jc2brown/radio24bb/README.md

# Baseband Modem

This repo contains RTL, baremetal firmware, and application software (all WIP) for the "Baseband" modem hardware, a general-purpose FPGA/DSP playground intended to implement the low-frequency portion (<20MHz) of a radio system.

- [Schematic](https://github.com/jc2brown/radio24bb/blob/master/hw/Baseband_Schematic.pdf)
- [Gerbers](https://github.com/jc2brown/radio24bb/blob/master/hw/Baseband_PCB.pdf)
- [Power Tree](https://github.com/jc2brown/radio24bb/blob/master/hw/Baseband_PowerTree.pdf)

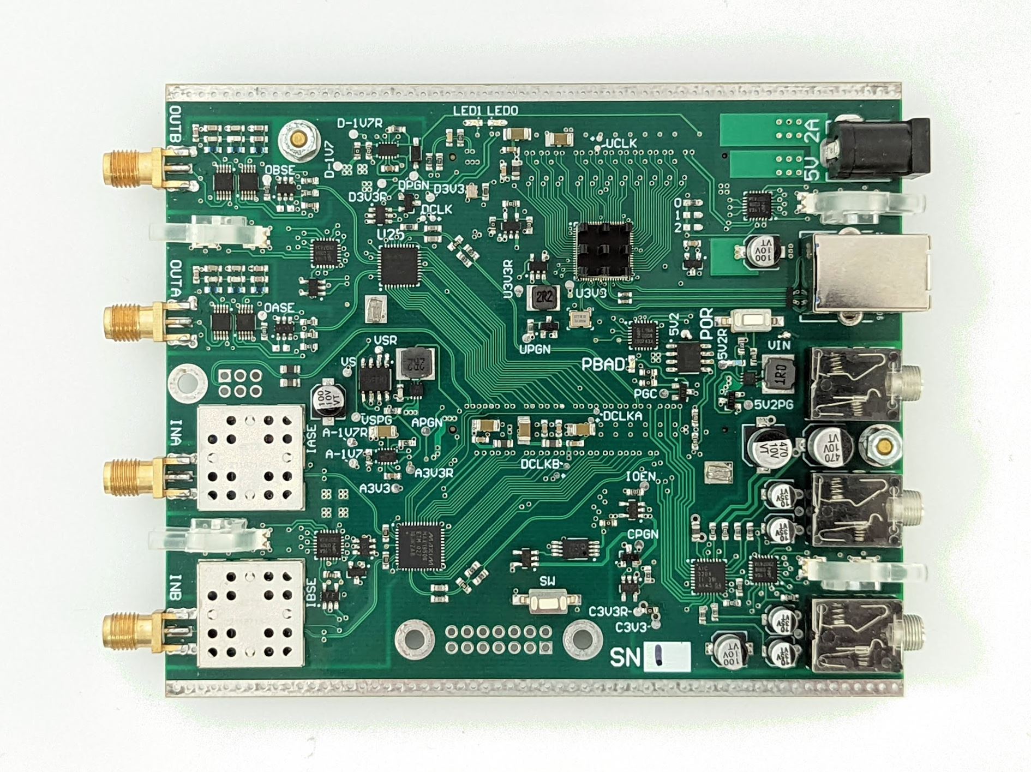
[picture p1: www/baseband_board_top.jpg]
Baseband board top view


### Generic Radio

Generic radio system

### This Implementation 

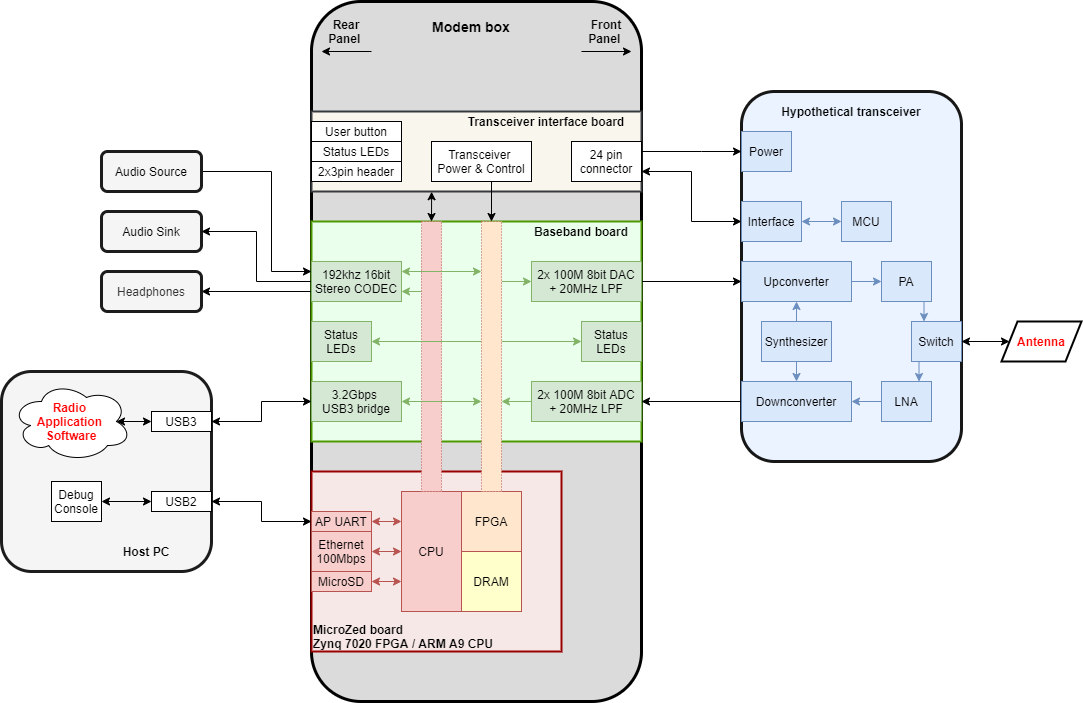
[picture p2: www/baseband_rxtx.png]
Block diagram


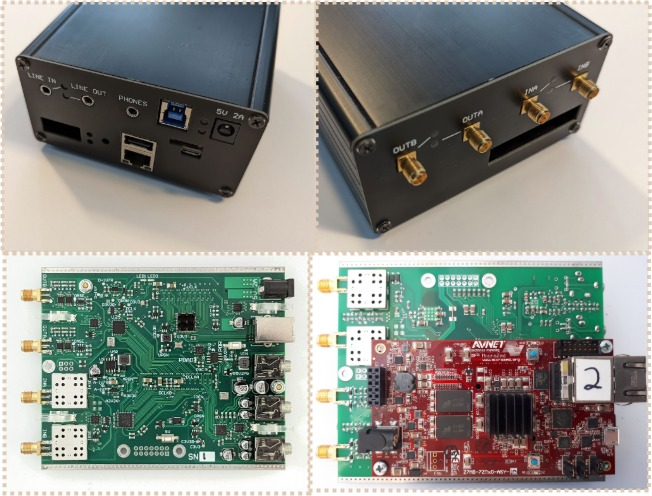
[picture p3: www/baseband_hw.jpg]
Baseband hardware
