jc2brown/radio24bb/rtl/readme.txt

Sources/Sinks

	ADC
		INA/INB (sources)
			Ext ATT
			Ext Filter
			Gain/Offset
			FIR filter

	DAC
		OUTA/OUTB (sinks)
			Ext ATT
			Ext Filter
			Gain/Offset
			FIR filter

	CODEC
		INL/INR (sources)
		OUTL/OUTR (sinks)

	USB
		IN (source)
		OUT (sink)

	DDSA/DDSB (sources)
		AM/FM/PM modulation

Blocks
	DDS
	FFT
	Filter
	Gain/Offset
	FM_Demod

TODO
	AM_Demod
	PM_Demod
	Resampler
