jc2brown/radio24bb/rtl/FT601_MCFIFO_Timing.png

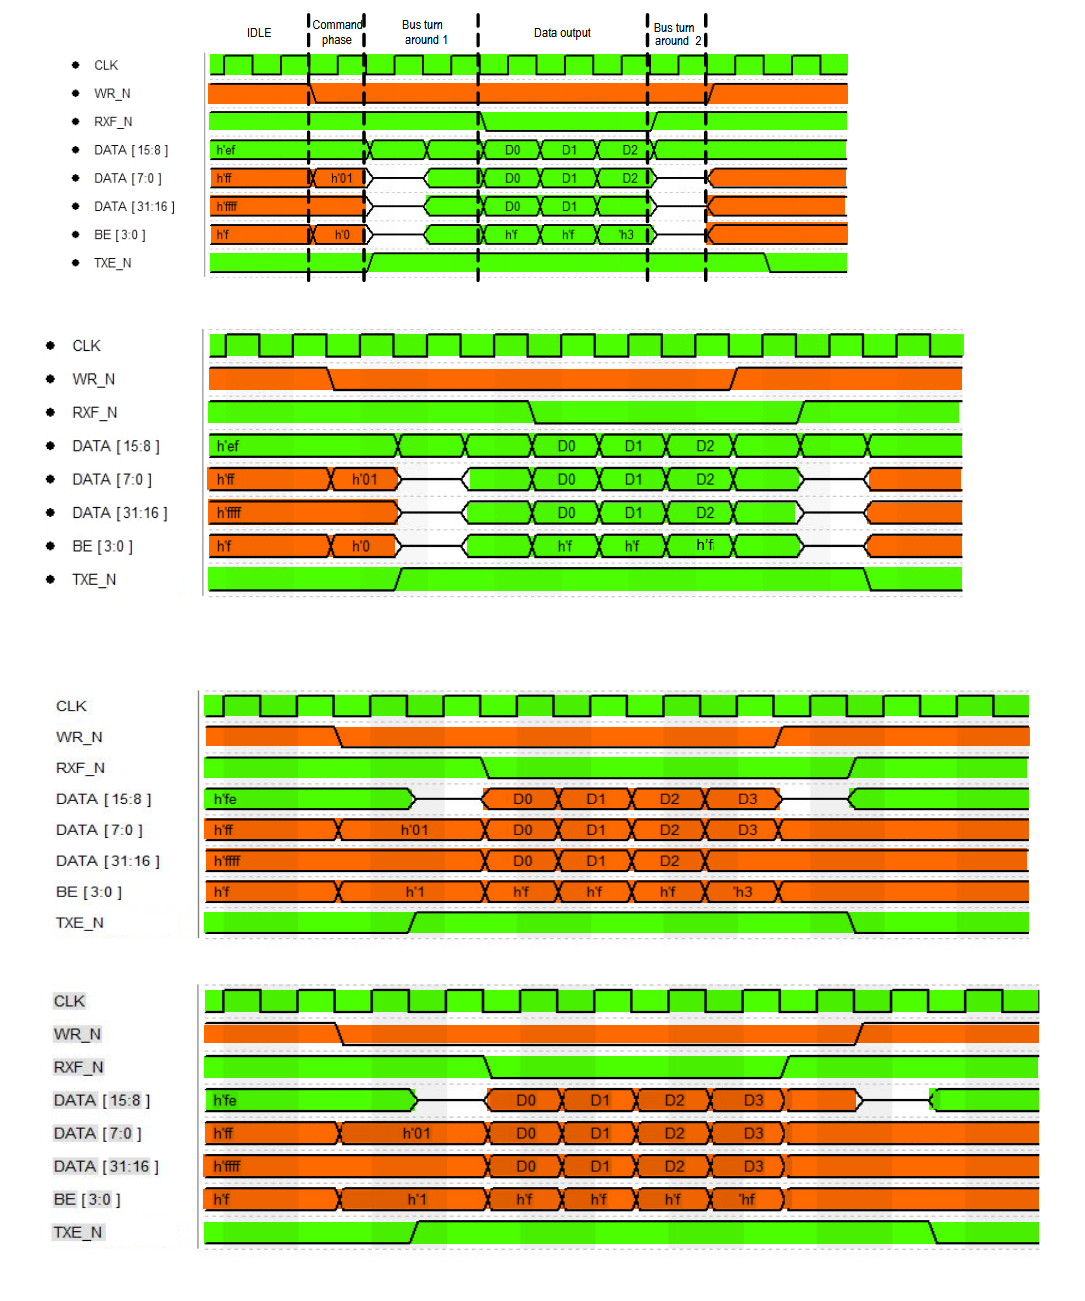
rtl/FT601_MCFIFO_Timing.png
