jc2brown/radio24bb/hw/Baseband_Schematic.pdf

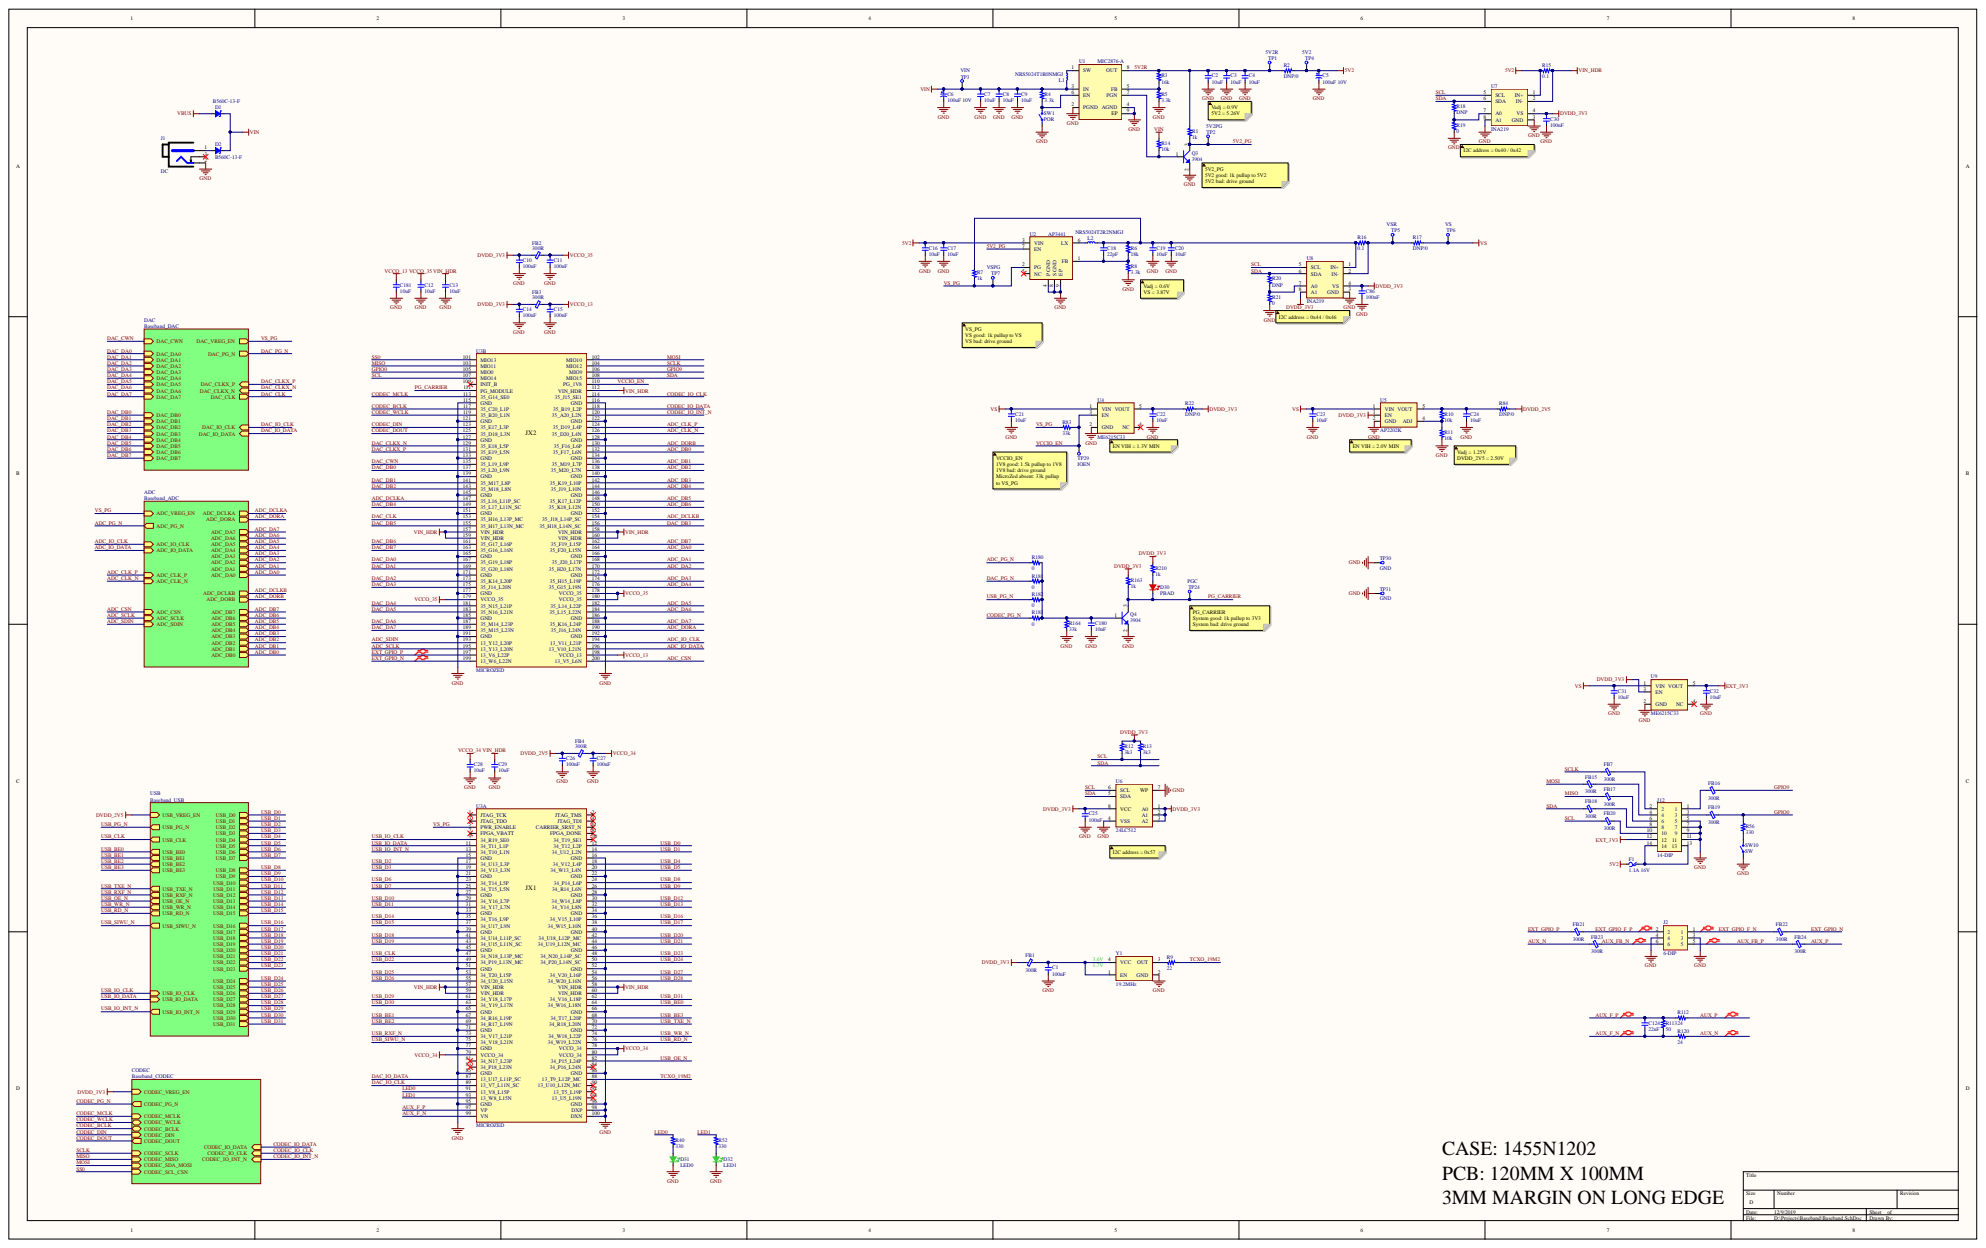
[picture p5: page 1]

DC GND DAC Baseband_DAC | DVDD_3V3 VCCO_13 C14 C15 100nF 100nF | | 5V2R 5V2 TP1 TP4 5V2 good: 1k pullup to 5V2 5V2 bad: drive ground

VS good: 1k pullup to VS
VS bad: drive ground

PG_CARRIER
System good: 1k pullup to 3V3
System bad: drive ground

CASE: 1455N1202
PCB: 120MM X 100MM
3MM MARGIN ON LONG EDGE

Size D | Number | Revision

Date: 12/9/2019 File: D:\Projects\Baseband\Baseband.SchDoc | Sheet of Drawn By:

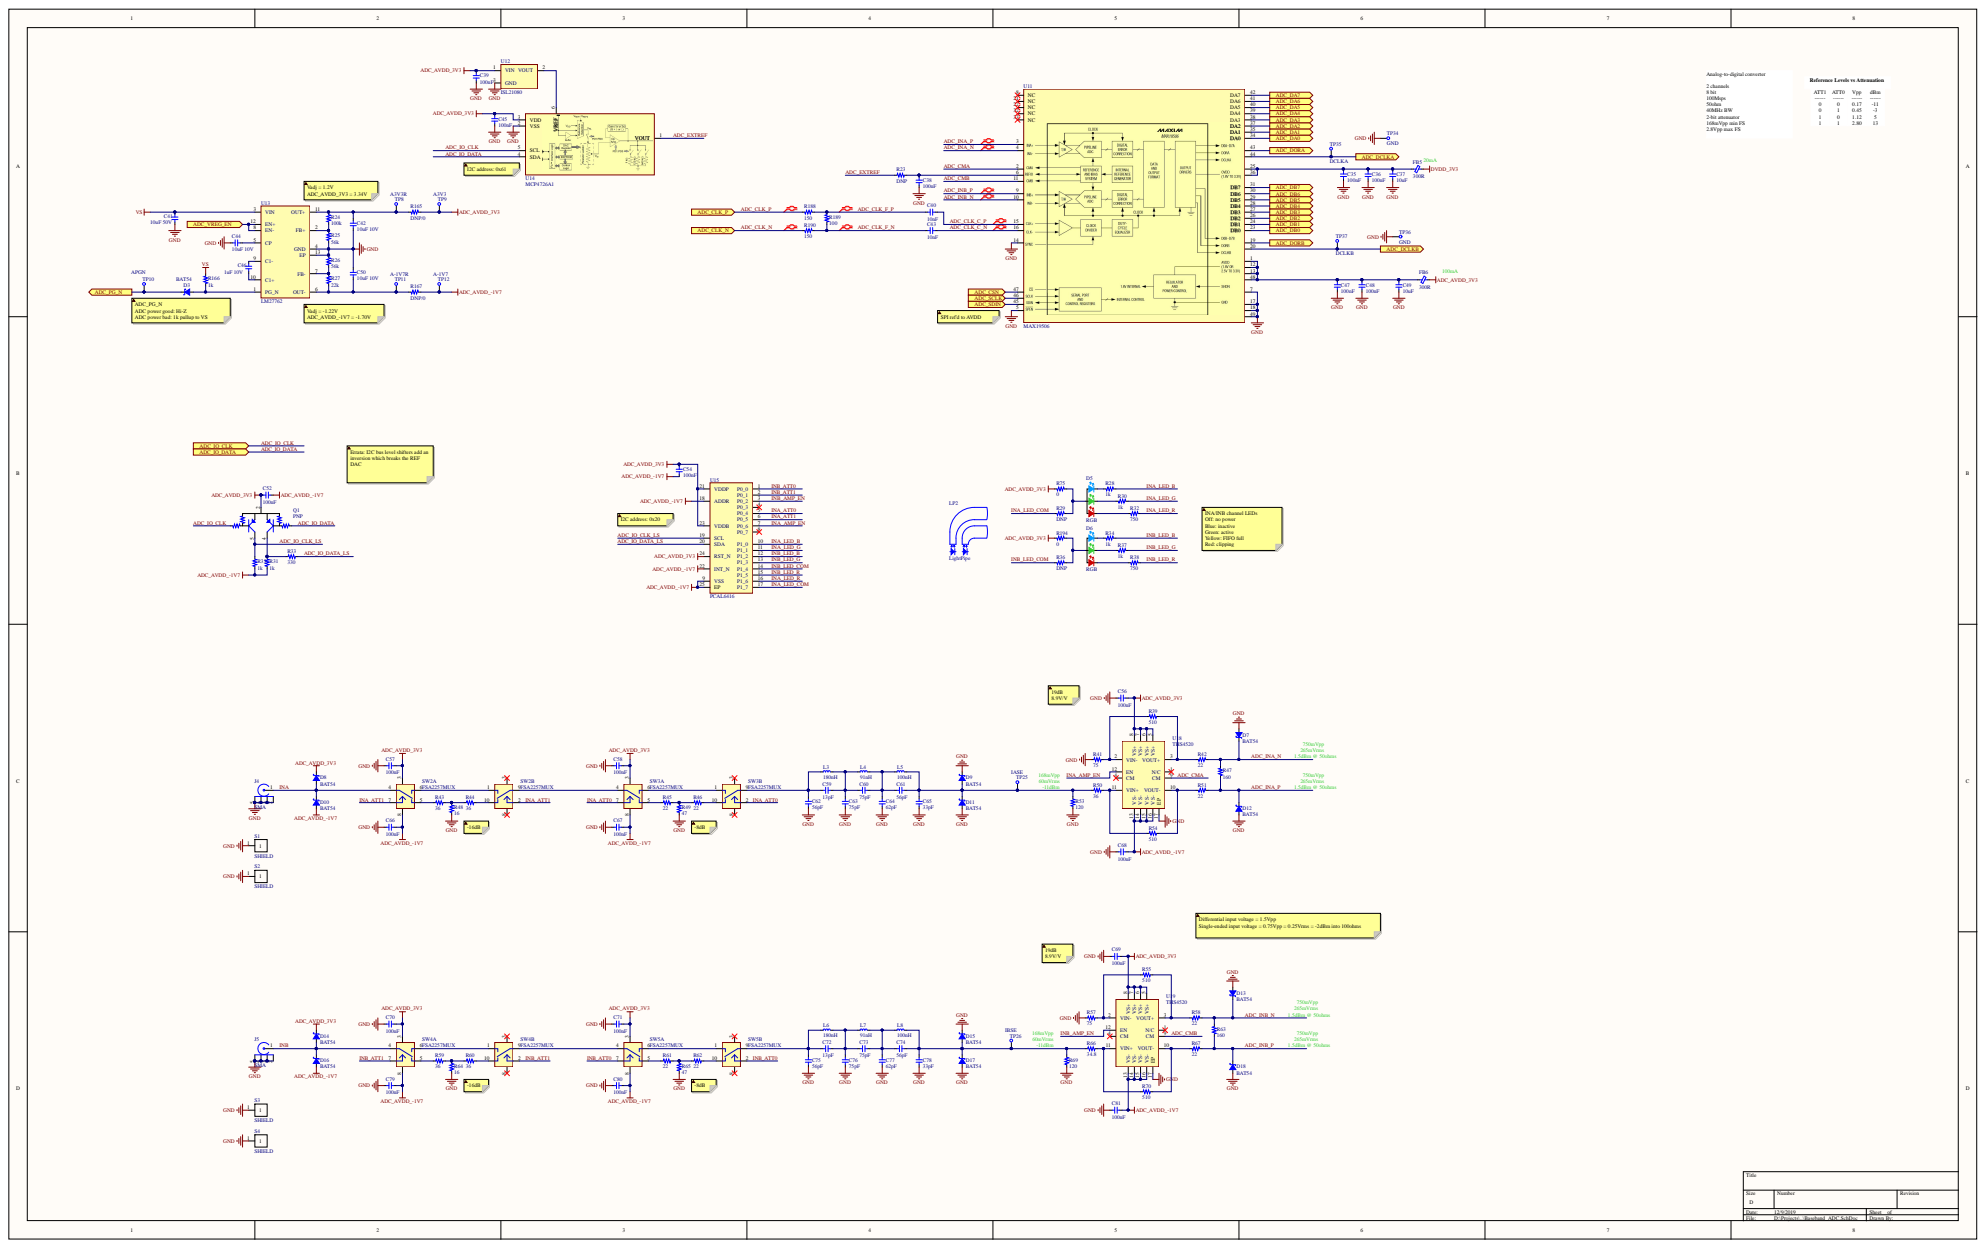
[picture p6: page 2]

Analog-to-digital converter

Reference Levels vs Attenuation

ADC_PG_N
ADC power good: Hi-Z
ADC power bad: 1k pullup to VS

SPI ref'd to AVDD

Errata: I2C bus level shifters add an
inversion which breaks the REF
DAC

INA/INB channel LEDs
Off: no power
Blue: inactive
Green: active
Yellow: FIFO full
Red: clipping

Differential input voltage = 1.5Vpp
Single-ended input voltage = 0.75Vpp = 0.25Vrms = -2dBm into 100ohms

Size D | Number | Revision

Date: 12/9/2019 File: D:\Projects\..\Baseband_ADC.SchDoc | Sheet of Drawn By:

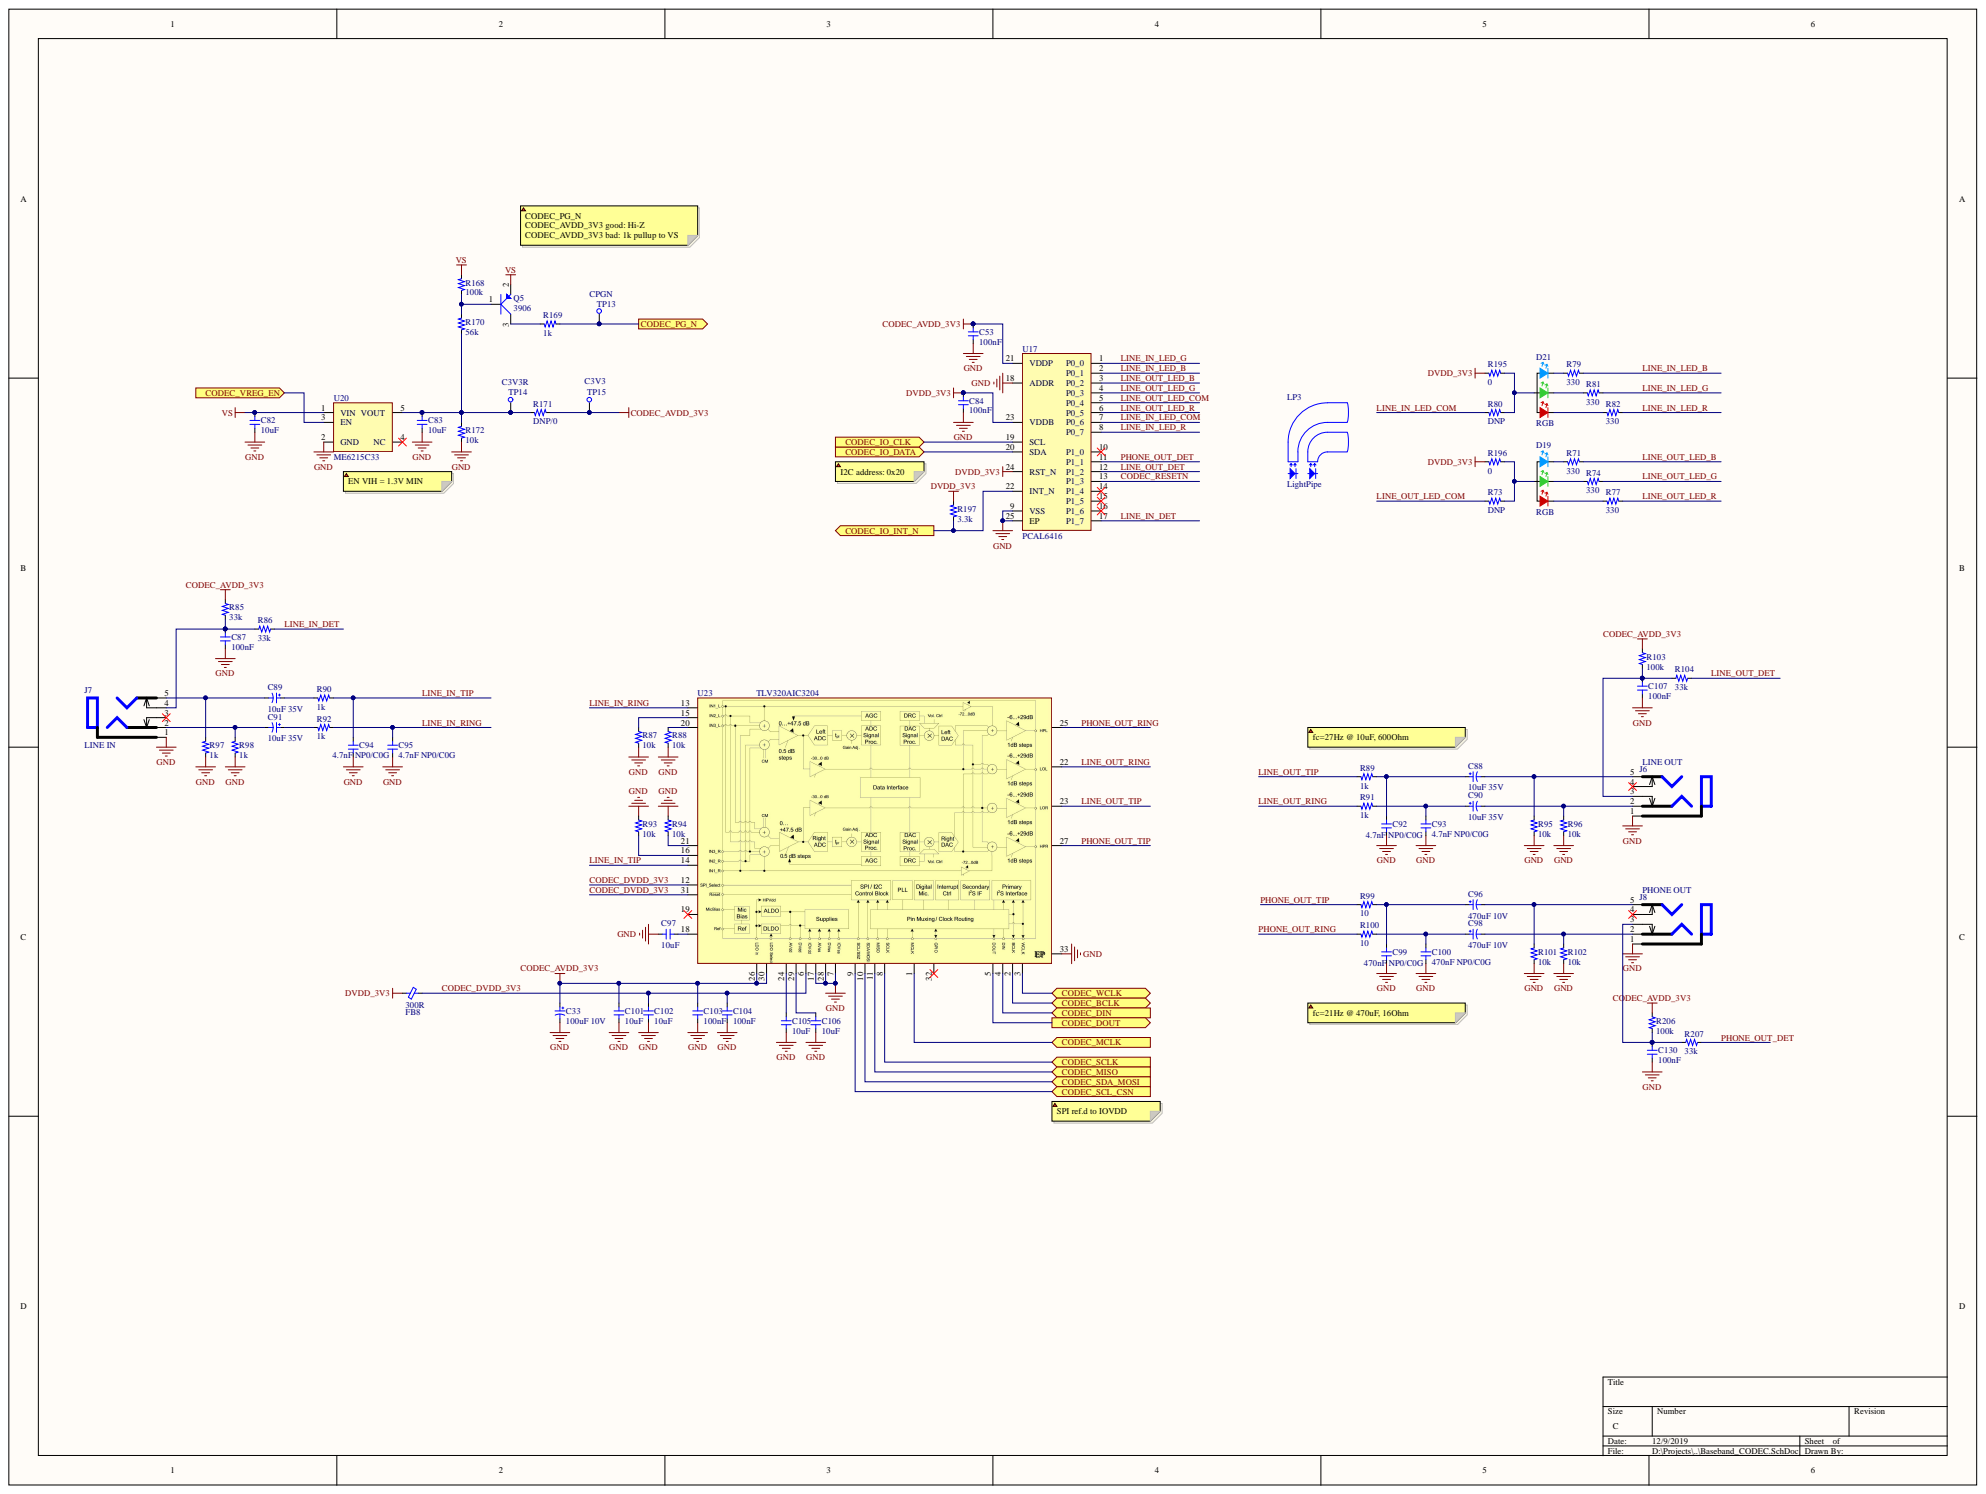
[picture p7: page 3]

CODEC_PG_N
CODEC_AVDD_3V3 good: Hi-Z
CODEC_AVDD_3V3 bad: 1k pullup to VS

SPI ref.d to IOVDD

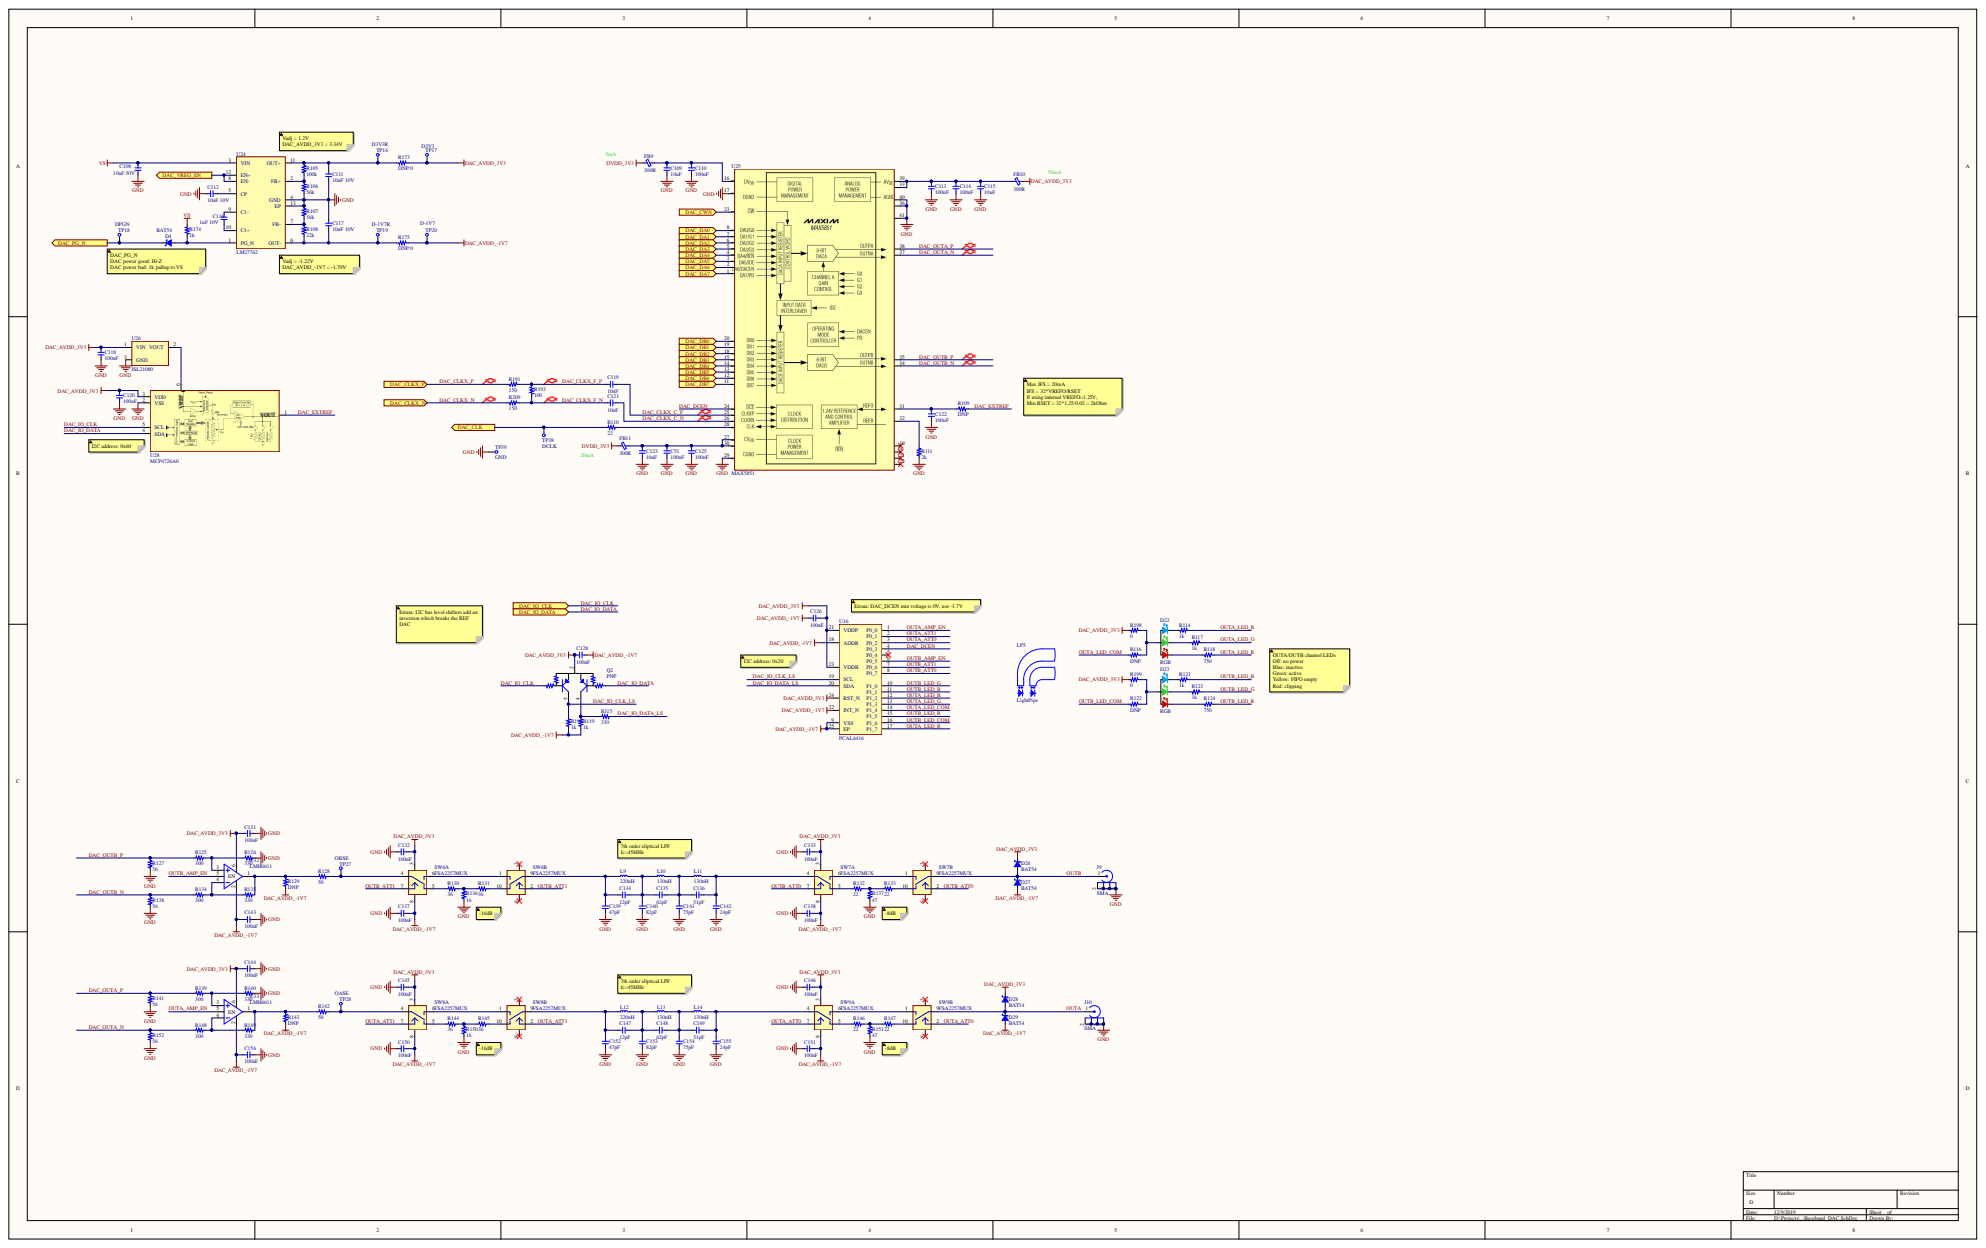
[picture p8: page 4]

DAC_PG_N
DAC power good: Hi-Z
DAC power bad: 1k pullup to VS

Max IFS = 20mA
IFS = 32*VREFO/RSET
If using internal VREFO=1.25V,
Min RSET = 32*1.25/0.02 = 2kOhm

Errata: DAC_DCEN min voltage is 0V, not -1.7V

Errata: I2C bus level shifters add an
inversion which breaks the REF
DAC

OUTA/OUTB channel LEDs
Off: no power
Blue: inactive
Green: active
Yellow: FIFO empty
Red: clipping

Size D | Number | Revision

Date: 12/9/2019 File: D:\Projects\..\Baseband_DAC.SchDoc | Sheet of Drawn By:

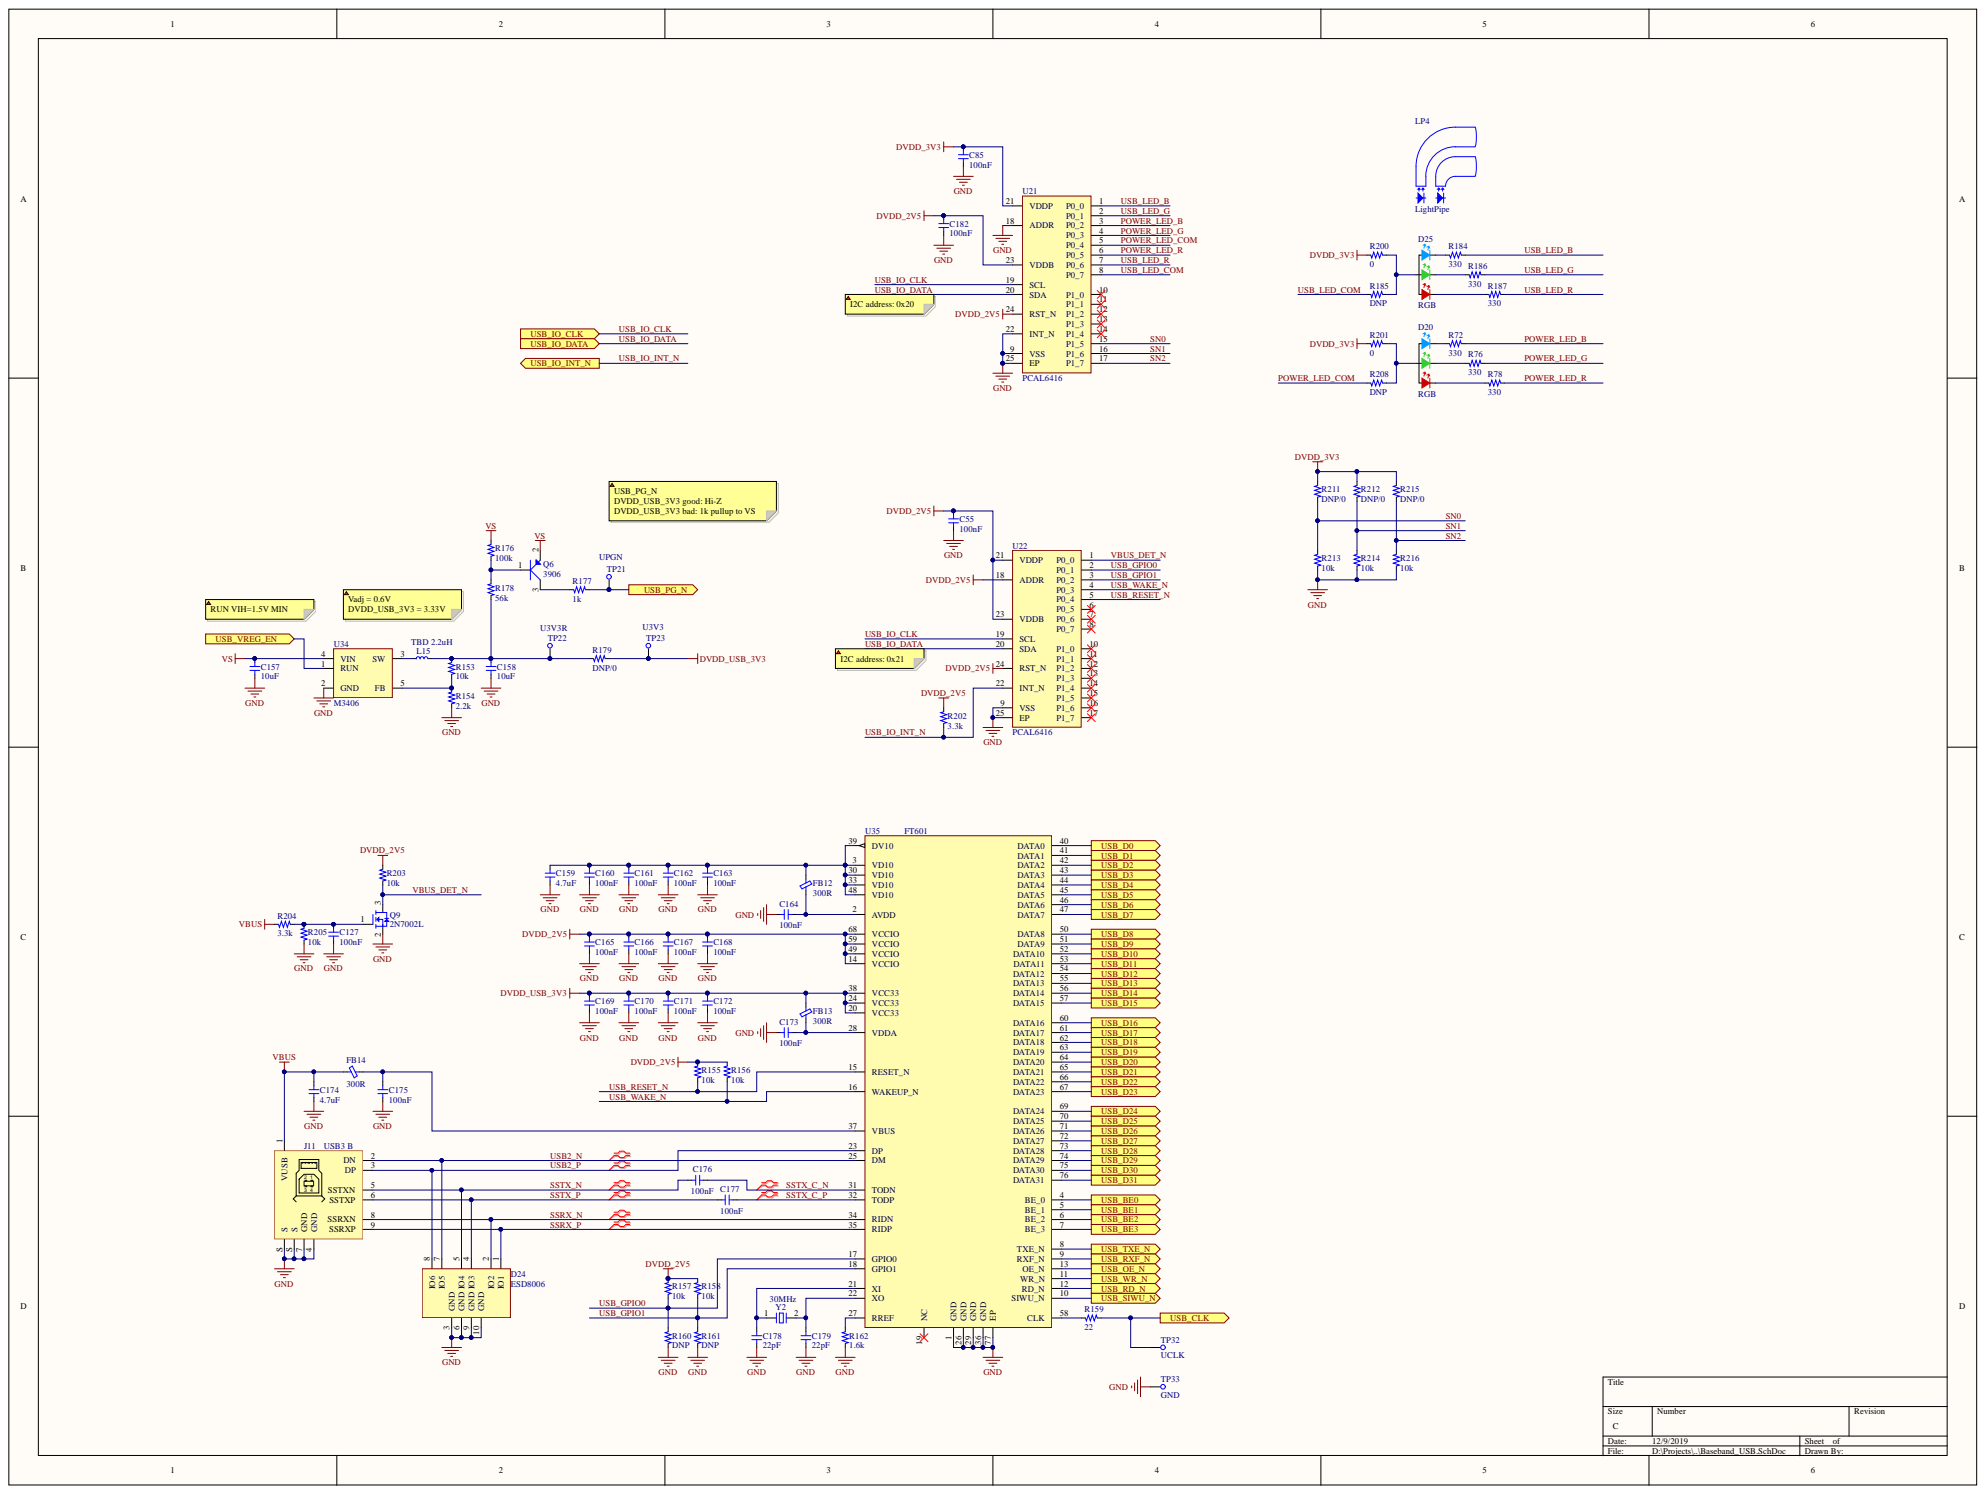
[picture p9: page 5]

USB_PG_N
DVDD_USB_3V3 good: Hi-Z
DVDD_USB_3V3 bad: 1k pullup to VS
