jc2brown/radio24bb/hw/Baseband_PowerTree.pdf

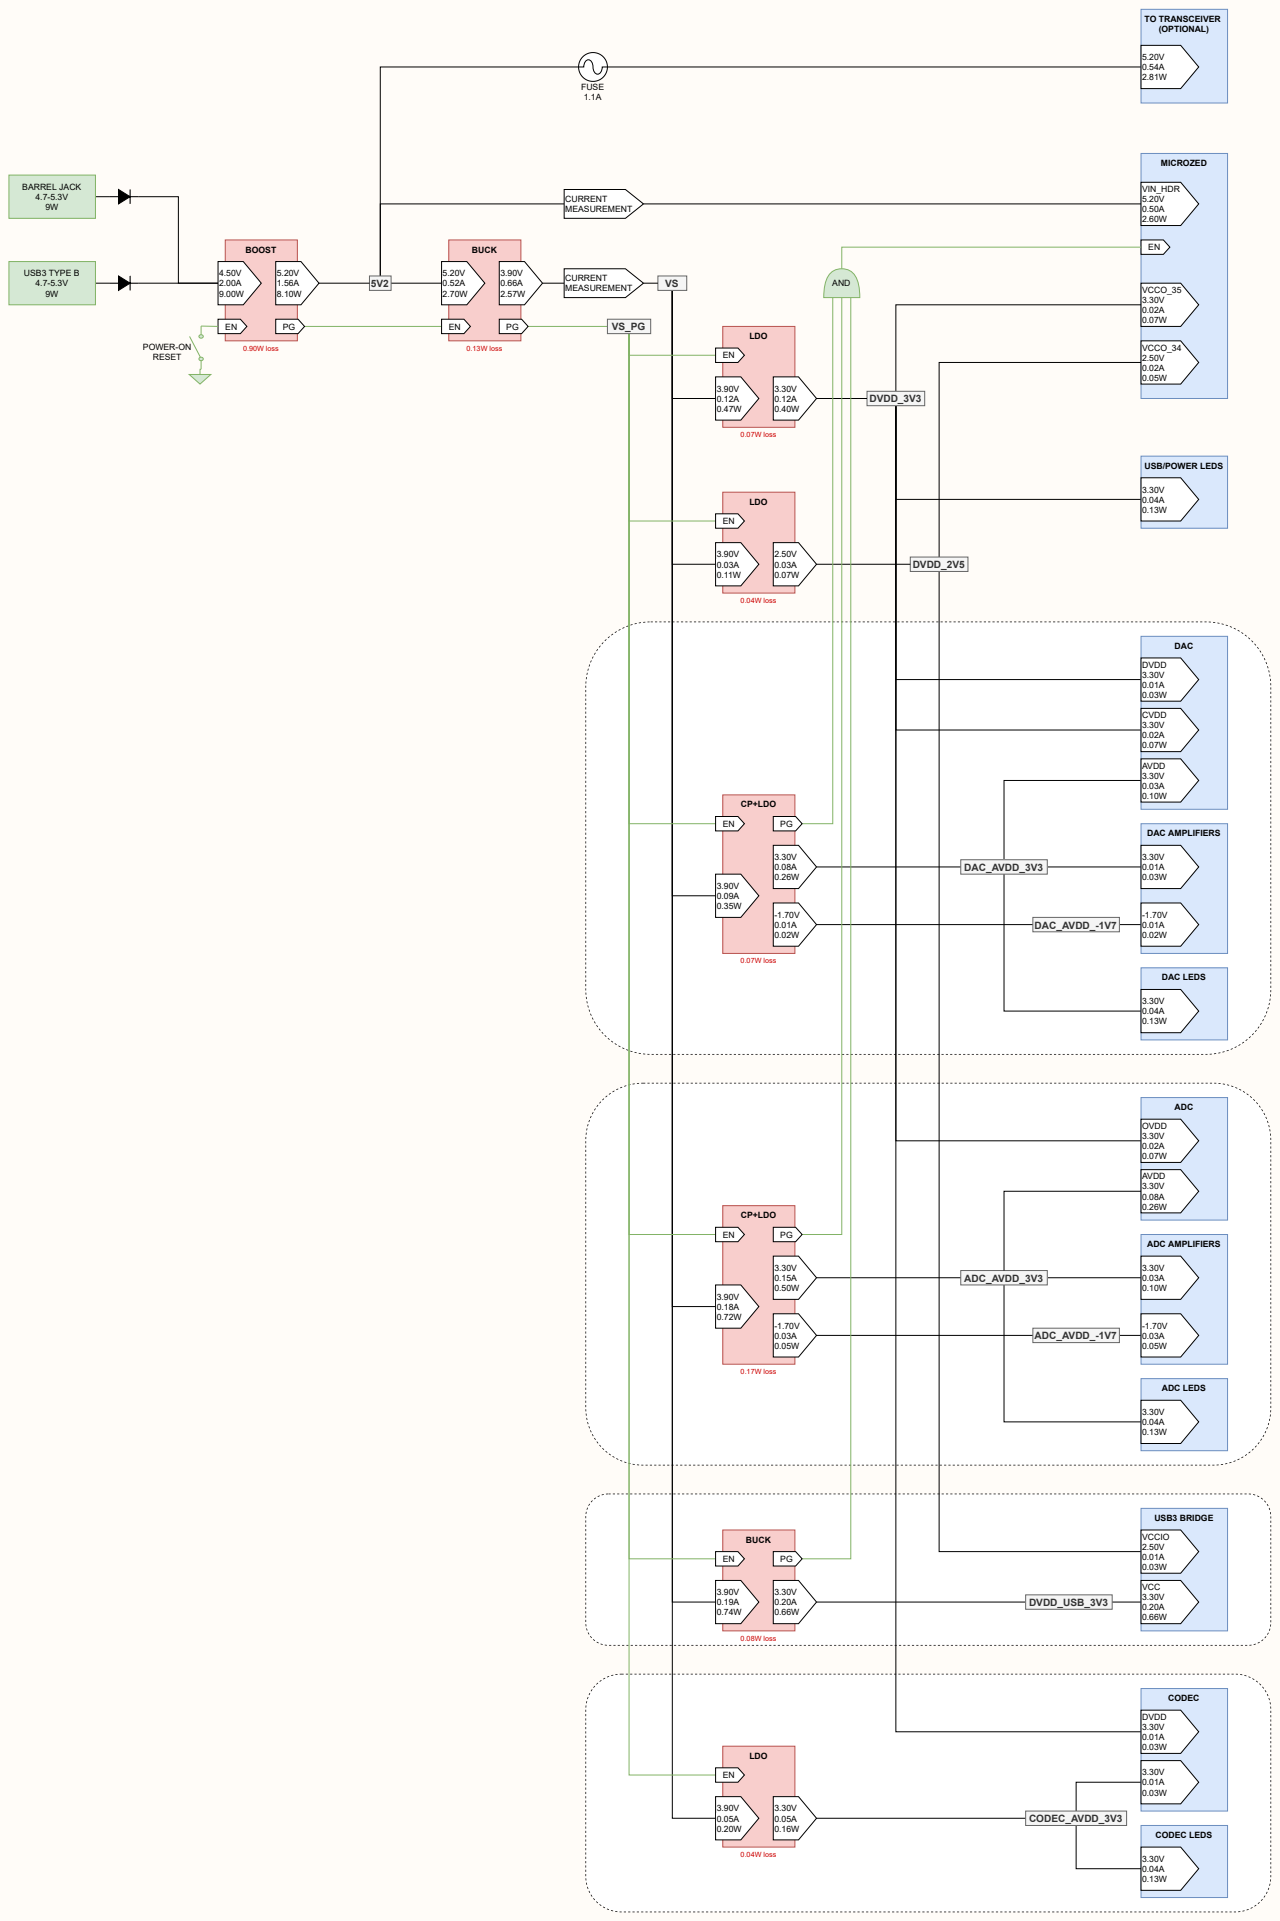
[picture p10: page 1]
BOOST; BUCK; MICROZED; BARREL JACK 4.7-5.3V 9W; USB3 TYPE B 4.7-5.3V 9W; TO TRANSCEIVER (OPTIONAL); FUSE 1.1A; CURRENT MEASUREMENT; VIN_HDR 5.20V 0.50A 2.60W; LDO; DVDD_2V5; POWER-ON RESET; CP+LDO; DAC_AVDD_3V3; DAC_AVDD_-1V7; ADC_AVDD_3V3; ADC_AVDD_-1V7; DVDD_USB_3V3; AND; USB3 BRIDGE; VCC 3.30V 0.20A 0.66W; VCCIO 2.50V 0.01A 0.03W; CODEC LEDS; CODEC_AVDD_3V3; CODEC; DVDD 3.30V 0.01A 0.03W; ADC AMPLIFIERS; ADC; AVDD 3.30V 0.08A 0.26W; ADC LEDS; DAC AMPLIFIERS; DAC; AVDD 3.30V 0.03A 0.10W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

DVDD_3V3

USB/POWER LEDS
