jc2brown/radio24bb/fw/src/main.c

#include <stdio.h>
#include <stdlib.h>
#include <math.h>
#include <stdbool.h>

#include "sleep.h"
#include "xparameters.h"
#include "xparameters_ps.h"
#include "xscugic.h"
#include "xadc.h"
#include "gpiops.h"
#include "uartps.h"
#include "fatfs.h"

#include "roe.h"

#include "command.h"

#include "i2c.h"

#include "ina219.h"

#include "aic3204.h"

#include "adc.h"
#include "dac.h"
#include "dds.h"
#include "mpx.h"
#include "wav.h"
#include "playback.h"

#include "radio24bb.h"



void usb_handler(void *arg, struct command *cmd) {

	struct radio24bb *r24bb = (struct radio24bb *)arg;

	static int n = 0;
	static char msg[1024];


	//USB_WR_PUSH = 1;


	sprintf(msg, "Hello #%d\n", n++);

	for (char *c = msg; *c != '\0'; ++c) {
		// USB_WR_DATA = *c;
		r24bb->regs->usb_wr_data = *c;
	}

	// USB_WR_PUSH = 1;
	r24bb->regs->usb_wr_push = 1;
/*

	for (int i = 0; i < 1024; ++i) {
		USB_WR_DATA = i;
	}
*/
}


void handle_ls_cmd(void *arg, struct command *cmd) {
	//struct radio24bb *r24bb = (struct radio24bb *)arg;
	fatfs_ls();
}



void handle_stat_cmd(void *arg, struct command *cmd) {
	struct radio24bb *r24bb = (struct radio24bb *)arg;

	char *path = cmd->tokens[cmd->index++];
	FILINFO fno;

	xil_printf("STAT %s\n", path);

	f_stat(path, &fno);

	xil_printf("size=%d\n", fno.fsize);
	xil_printf("\n");

}





void handle_wavstat_cmd(void *arg, struct command *cmd) {
	struct radio24bb *r24bb = (struct radio24bb *)arg;
	char *path = cmd->tokens[cmd->index++];
	wavstat(path, NULL);
}










int pin_value = 0;
void gpio_handler(void *arg, struct command *cmd) {
	xil_printf(".\n");
	
	struct radio24bb *r24bb = (struct radio24bb *)arg;
	XGpioPs_SetDirectionPin(r24bb->gpiops, 57, 1); // output
	XGpioPs_SetOutputEnablePin(r24bb->gpiops, 57, 1);
	pin_value = !pin_value;
	XGpioPs_WritePin(r24bb->gpiops, 57, pin_value);
	xil_printf("pinstat: %d\n", XGpioPs_ReadPin(r24bb->gpiops, INTR_IN_PIN));
	xil_printf("intstat: %d\n", XGpioPs_IntrGetStatusPin(r24bb->gpiops, INTR_IN_PIN));
	
}



/*
void tonea_handler(void *arg, struct command *cmd) {
	issue_command("ddsa src dds", NULL);
	issue_command("ddsa freq 10.7e6", NULL);
	issue_command("ddsa fm src aud", NULL);
	issue_command("ddsa fm gain 300", NULL);
	issue_command("outa src ddsa", NULL);
}
*/




char *stereo_script[] = {

	"ddsa am src raw",	
	"ddsa am raw 127",	
	"ddsa am gain 256",	
	"ddsa am offset 0",
	"ddsa fm gain 0",	
	"ddsa fm offset 0",
	"ddsa pm gain 0",	
	"ddsa pm offset 0",

	"ddsa src dds",
	"ddsa freq 10.7e6",
	"ddsa fm src mpx",
	"ddsa fm gain 400",
	"ddsa fm offset 0",

	"mpx pilot 1000",

	"outa src ddsa",

	"outb src ddsb",
	"outb att 0",

	"ddsb src mpx"


};




char *amtone_script[] = {

	"ddsb src dds",
	"ddsb freq 1e3",
	"ddsb fm src raw",


	"ddsa am src raw",	
	"ddsa am raw 127",	
	"ddsa am gain 256",	
	"ddsa am offset 0",
	"ddsa fm gain 0",	
	"ddsa fm offset 0",
	"ddsa pm gain 0",	
	"ddsa pm offset 0",



	"ddsa src dds",
	"ddsa freq 19.7e6",
	"ddsa am src ddsb",
	"ddsa am gain 127",
	"ddsa am offset 64",

	"outa src ddsa",
	"outb src ddsa",

};





char *fmtone_script[] = {

	"ddsb src dds",
	"ddsb freq 1e3",
	"ddsb fm src raw",

	"ddsa am src raw",	
	"ddsa am raw 127",	
	"ddsa am gain 256",	
	"ddsa am offset 0",
	"ddsa fm gain 0",	
	"ddsa fm offset 0",
	"ddsa pm gain 0",	
	"ddsa pm offset 0",

	"ddsa src dds",
	"ddsa freq 19.7e6",
	"ddsa fm src ddsb",
	"ddsa fm gain 10000",
	"ddsa fm offset 0",

	"outa src ddsa",
	"outb src ddsa",

};





char *pmtone_script[] = {

	"ddsb src dds",
	"ddsb freq 1e3",
	"ddsb fm src raw",

	"ddsa am src raw",	
	"ddsa am raw 127",	
	"ddsa am gain 256",	
	"ddsa am offset 0",
	"ddsa fm gain 0",	
	"ddsa fm offset 0",
	"ddsa pm gain 0",	
	"ddsa pm offset 0",

	"ddsa src dds",
	"ddsa freq 19.7e6",
	"ddsa fm src raw",
	"ddsa am src raw",
	"ddsa pm src ddsb",
	"ddsa pm gain 2048",

	"outa src ddsa",
	"outb src ddsa",

};


void stereo_handler(void *arg, struct command *cmd) {
	struct radio24bb *r24bb = (struct radio24bb *)arg;
	run_script(r24bb->shell, stereo_script);
}

void amtone_handler(void *arg, struct command *cmd) {
	struct radio24bb *r24bb = (struct radio24bb *)arg;
	run_script(r24bb->shell, amtone_script);
}
	
void fmtone_handler(void *arg, struct command *cmd) {
	struct radio24bb *r24bb = (struct radio24bb *)arg;
	run_script(r24bb->shell, fmtone_script);
}
	
void pmtone_handler(void *arg, struct command *cmd) {
	struct radio24bb *r24bb = (struct radio24bb *)arg;
	run_script(r24bb->shell, pmtone_script);
}
	



void loopa_handler(void *arg, struct command *cmd) {
	struct radio24bb *r24bb = (struct radio24bb *)arg;
	issue_command(r24bb->shell, "outa src ina", NULL);
	issue_command(r24bb->shell, "ina att 0", NULL);
	issue_command(r24bb->shell, "outa att 0", NULL);
	issue_command(r24bb->shell, "ina opt", NULL);
	issue_command(r24bb->shell, "outa opt", NULL);
}



void info_handler(void *arg, struct command *cmd) {
	//struct radio24bb *r24bb = (struct radio24bb *)arg;
	xil_printf("INFO\n");
}

void led_handler(void *arg, struct command *cmd) {
	struct radio24bb *r24bb = (struct radio24bb *)arg;

	int ina_led = 0;
	int inb_led = 0;
	int outa_led = 0;
	int outb_led = 0;

	char buf[64];

	for (int i = 0; i < 8; ++i) {

		sprintf(buf, "ina led %d", ina_led);
		ina_led = (ina_led + 1) % 8;
		issue_command(r24bb->shell, buf, NULL);

		sprintf(buf, "inb led %d", inb_led);
		inb_led = (inb_led + 1) % 8;
		issue_command(r24bb->shell, buf, NULL);

		sprintf(buf, "outa led %d", outa_led);
		outa_led = (outa_led + 1) % 8;
		issue_command(r24bb->shell, buf, NULL);

		sprintf(buf, "outb led %d", outb_led);
		outb_led = (outb_led + 1) % 8;
		issue_command(r24bb->shell, buf, NULL);

		usleep(100000);
	}

	issue_command(r24bb->shell, "ina led 0", NULL);
	issue_command(r24bb->shell, "inb led 0", NULL);
	issue_command(r24bb->shell, "outa led 0", NULL);
	issue_command(r24bb->shell, "outb led 0", NULL);

}





// void xadc_handler(void *arg, struct command *cmd) {
// 	xadc_report(r24bb->xadc);
// }



















#if 0



#include "xparameters.h"	
#include "xsdps.h"		
#include "xil_printf.h"
#include "ff.h"
#include "xil_cache.h"
#include "xplatform_info.h"


int FfsSdPolledExample(void);

static FIL fil;	
static FATFS fatfs;

 //  To test logical drive 0, FileName should be "0:/<File name>" or
 //  "<file_name>". For logical drive 1, FileName should be "1:/<file_name>"
 
static char FileName[32] = "Test.bin";
static char *SD_File;
u32 Platform;

#ifdef __ICCARM__
#pragma data_alignment = 32
u8 DestinationAddress[10*1024*1024];
u8 SourceAddress[10*1024*1024];
#pragma data_alignment = 4
#else
u8 DestinationAddress[10*1024*1024] __attribute__ ((aligned(32)));
u8 SourceAddress[10*1024*1024] __attribute__ ((aligned(32)));
#endif

#define TEST 7




int FfsSdPolledExample(void)
{
	FRESULT Res;
	UINT NumBytesRead;
	UINT NumBytesWritten;
	u32 BuffCnt;
	u32 FileSize = (8*1024*1024);
	/*
	 * To test logical drive 0, Path should be "0:/"
	 * For logical drive 1, Path should be "1:/"
	 */

	Platform = XGetPlatform_Info();
	if (Platform == XPLAT_ZYNQ_ULTRA_MP) {
		/*
		 * Since 8MB in Emulation Platform taking long time, reduced
		 * file size to 8KB.
		 */
		FileSize = 8*1024;
	}

	DIR dp;
	Res = f_opendir(&dp, "0:/");
	if (Res != FR_OK) {
		xil_printf("no dir\n");
		return XST_FAILURE;
	}


	FILINFO fno;

	while (1) {

		fno.fname[0] = '\0';
		Res = f_readdir(&dp, &fno);

		if (fno.fname[0] == '\0') {		
			xil_printf("end of dir\n");
			break;
		}
		else if (Res != FR_OK) {
			xil_printf("readdir failed\n");
			return XST_FAILURE;
		}
		xil_printf("fname=%s\n", fno.fname);
		usleep(10000);
	}
	Res = f_closedir(&dp);
	if (Res != FR_OK) {
		xil_printf("closedir failed\n");
		return XST_FAILURE;
	}



	xil_printf("done\n");
	return XST_SUCCESS;


	/*
	 * Open file with required permissions.
	 * Here - Creating new file with read/write permissions. .
	 * To open file with write permissions, file system should not
	 * be in Read Only mode.
	 */
	SD_File = (char *)FileName;

	Res = f_open(&fil, SD_File, FA_CREATE_ALWAYS | FA_WRITE | FA_READ);
	if (Res) {
		return XST_FAILURE;
	}

	/*
	 * Pointer to beginning of file .
	 */
	Res = f_lseek(&fil, 0);
	if (Res) {
		return XST_FAILURE;
	}

	/*
	 * Write data to file.
	 */
	Res = f_write(&fil, (const void*)SourceAddress, FileSize,
			&NumBytesWritten);
	if (Res) {
		return XST_FAILURE;
	}

	/*
	 * Pointer to beginning of file .
	 */
	Res = f_lseek(&fil, 0);
	if (Res) {
		return XST_FAILURE;
	}

	/*
	 * Read data from file.
	 */
	Res = f_read(&fil, (void*)DestinationAddress, FileSize,
			&NumBytesRead);
	if (Res) {
		return XST_FAILURE;
	}

	/*
	 * Data verification
	 */
	for(BuffCnt = 0; BuffCnt < FileSize; BuffCnt++){
		if(SourceAddress[BuffCnt] != DestinationAddress[BuffCnt]){
			return XST_FAILURE;
		}
	}

	/*
	 * Close file.
	 */
	Res = f_close(&fil);
	if (Res) {
		return XST_FAILURE;
	}

	return XST_SUCCESS;
}






#endif












/*
void outbyte(char c) {

}
*/



#define R24BB_REGS 0x43C04000UL










int main()
{



	xil_printf("\n\n");
	xil_printf("##############################################\n");
	xil_printf("\n");

	//_return_if_error_(ina219_config());


	xil_printf("Starting Baseband... \n");


	xil_printf("Allocating devices... \n");
	struct radio24bb *r24bb = make_radio24bb();
	if (r24bb == NULL) {
		xil_printf("FATAL: failed allocating devices.\n");
		while (1);
	}
	xil_printf("Done allocating devices.\n");

	
	xil_printf("Initializing devices... \n");
	init_radio24bb(r24bb, R24BB_REGS);
	xil_printf("Done initializing devices.\n");

	xil_printf("Baseband %d ready \n", get_serial(r24bb));
	xil_printf("\n");



	// add_command(NULL, "xadc", xadc_handler);

	//add_command(NULL, "tonea", tonea_handler);
	add_command(r24bb->shell->root_ctx, "usb", usb_handler);
	add_command(r24bb->shell->root_ctx, "stereo", stereo_handler);
	add_command(r24bb->shell->root_ctx, "amtone", amtone_handler);
	add_command(r24bb->shell->root_ctx, "fmtone", fmtone_handler);
	add_command(r24bb->shell->root_ctx, "pmtone", pmtone_handler);
	add_command(r24bb->shell->root_ctx, "loopa", loopa_handler);
	add_command(r24bb->shell->root_ctx, "info", info_handler);
	add_command(r24bb->shell->root_ctx, "led", led_handler);

	add_command(r24bb->shell->root_ctx, "gpio", gpio_handler);
	add_command(r24bb->shell->root_ctx, "ls", handle_ls_cmd);
	add_command(r24bb->shell->root_ctx, "stat", handle_stat_cmd);
	add_command(r24bb->shell->root_ctx, "wavstat", handle_wavstat_cmd);


	issue_command(r24bb->shell, "outa att 0", NULL);
	issue_command(r24bb->shell, "outb att 3", NULL);


	issue_command(r24bb->shell, "led", NULL);

	issue_command(r24bb->shell, "ina led 0", NULL);
	issue_command(r24bb->shell, "inb led 0", NULL);
	issue_command(r24bb->shell, "outa led 0", NULL);
	issue_command(r24bb->shell, "outb led 0", NULL);

	issue_command(r24bb->shell, "stereo", NULL);

	issue_command(r24bb->shell, "aud vol -18", NULL);

	print_cmd_responses(true);


	r24bb->regs->audout_mux = 1;


/*

	int Status;

	xil_printf("SD Polled File System Example Test \r\n");

	Status = FfsSdPolledExample();
	if (Status != XST_SUCCESS) {
		xil_printf("SD Polled File System Example Test failed \r\n");
		return XST_FAILURE;
	}

	xil_printf("Successfully ran SD Polled File System Example Test \r\n");
*/



	int avail = r24bb->uart->rx_queue->size;
	if (avail != 0) {
		int c;
		for (int i = 0; i < avail; ++i) {
			queue_get(r24bb->uart->rx_queue, (void **)&c);
		}
		xil_printf("\n");
	}



	char cmd_buf[1024];
	char *cmd_buf_idx = cmd_buf;


	cmd_prompt(r24bb->shell);

	while (1) {


		//int ireg = mfcpsr();
		// Xil_ExceptionDisable();



		int avail = r24bb->uart->rx_queue->size;

		if (avail != 0) {
			int c;
			for (int i = 0; i < avail; ++i) {
				int j;
				queue_get(r24bb->uart->rx_queue, (void **)&j);
				*cmd_buf_idx = (char)j;
				if (*cmd_buf_idx == '\n') {
					*(cmd_buf_idx+1) = '\0';
					handle_command(r24bb->shell, cmd_buf);
					cmd_buf_idx = cmd_buf;
				} else {
					++cmd_buf_idx;
				}
				//xil_printf("%c", (char)c);
//				outbyte((char)c);
			}
			xil_printf("\n");
			//fatfs_ls();
		}

		//mtcpsr(ireg);

		usleep(1000);


		//handle_command();
		//fatfs_ls();
	}


	return 0;
}

/*

		if (!strncmp(tokens[0], "power", 5)) {
			int vled_mv;
			ina219_read_vled_mv(&vled_mv);
			xil_printf("vled_mv=%d\n", vled_mv);
			int iled_ma;
			ina219_read_iled_ma(&iled_ma);
			xil_printf("iled_ma=%d\n", iled_ma);
			int pled_mw;
			ina219_read_pled_mw(&pled_mw);
			xil_printf("pled_mw=%d\n", pled_mw);
		}



			if (!strcmp(tokens[1], "filt")) {

				switch (atoi(tokens[2])) {
				case 0:
					for (int i = 0; i < 21; ++i) {
						INA_FILTER_COEF = (uint32_t)(ina_filter0_coef[i] * (double)(1<<23));
					}
					xil_printf("INA_FILTER_COEF <= ina_filter0\n");
					break;
				case 1:
					for (int i = 0; i < 21; ++i) {
						INA_FILTER_COEF = (uint32_t)(ina_filter1_coef[i] * (double)(1<<23));
					}
					xil_printf("INA_FILTER_COEF <= ina_filter1\n");
					break;
				case 2:
					for (int i = 0; i < 21; ++i) {
						INA_FILTER_COEF = (uint32_t)(ina_filter2_coef[20-i] * (double)(1<<23));
					}
					xil_printf("INA_FILTER_COEF <= ina_filter2\n");
					break;
				case 3:
					for (int i = 0; i < 21; ++i) {
						INA_FILTER_COEF = (uint32_t)(ina_filter3_coef[20-i] * (double)(1<<23));
					}
					xil_printf("INA_FILTER_COEF <= ina_filter3\n");
					break;

				}



				//xil_printf("INA_FILTER_COEF <= %d\n", INA_FILTER_COEF = strtoul(tokens[2], NULL, 0));
			}




		if (!strcmp(tokens[0], "dac")) {
			if (!strcmp(tokens[1], "cfg")) {
				xil_printf("DAC_CFG <= %d\n", DAC_CFG = strtoul(tokens[2], NULL, 0));
			}
		}

		if (!strcmp(tokens[0], "usb")) {
			if (!strcmp(tokens[1], "wrmux")) {
				xil_printf("USB_WR_MUX <= %d\n", USB_WR_MUX = strtoul(tokens[2], NULL, 0));
			}
			if (!strcmp(tokens[1], "wr")) {
				for (int i = 0; i < 1024; ++i) {
					xil_printf("USB_WR_DATA <= %d\n", USB_WR_DATA = strtoul(tokens[2], NULL, 0));
				}
			}
		}


*/








//
//
//		//xil_printf("%d\n", *((volatile uint32_t*)(0x43C01000ULL)));
//		//xil_printf("%d\n", *((volatile uint32_t*)(0x43C00008)));
//
//		XGpioPs_WritePin(gpiops_ptr, 67, !XGpioPs_ReadPin(gpiops_ptr, 57)); // INB_R on DORB
//		XGpioPs_WritePin(gpiops_ptr, 68, !XGpioPs_ReadPin(gpiops_ptr, 61)); // INA_R on DORA
//
//		//XGpioPs_WritePin(gpiops_ptr, 72, 0);	// OUTA ATT0
//		//XGpioPs_WritePin(gpiops_ptr, 77, 0);  // OUTB ATT0
//
//		//xil_printf("USB_RD_EMPTY = %d\r\n", USB_RD_EMPTY);
//		if (!USB_RD_EMPTY) {
//			xil_printf("Starting read...\r\n");
//			int i = 0;
//			uint32_t x = 0, y = 0;
//			while (!USB_RD_EMPTY) {
//				y = x;
//				x = USB_RD_DATA;
//				//if (x-y!=1) {
//				if (x-y!=0x01010101 && !(x==0&&y==-1)) {
//					xil_printf("E 0x%08X 0x%08X\n", x, y);
//				}
//				/*
//				if (i < 20) {
//					xil_printf("0x%08X\n", x);
//				}
//				*/
//				++i;
//			}
//			xil_printf("Done read.\r\n");
//			xil_printf("%d\n", i);
//
//		}


		//usleep(100000);



		//USB_WR_DATA = c++;







#if 0

#include "xdevcfg.h"

#include "bitfile1.h"

#include "xparameters.h"
#include "xdevcfg.h"

#define DCFG_DEVICE_ID		XPAR_XDCFG_0_DEVICE_ID

#define SLCR_LOCK	0xF8000004
#define SLCR_UNLOCK	0xF8000008
#define SLCR_LVL_SHFTR_EN 0xF8000900
#define SLCR_PCAP_CLK_CTRL XPAR_PS7_SLCR_0_S_AXI_BASEADDR + 0x168

#define SLCR_PCAP_CLK_CTRL_EN_MASK 0x1
#define SLCR_LOCK_VAL	0x767B
#define SLCR_UNLOCK_VAL	0xDF0D


XDcfg DcfgInst;

int XDcfgPolledExample(uint8_t *bitfile, uint32_t bitfile_size)
{
	int Status;
	u32 IntrStsReg = 0;
	u32 StatusReg;
	u32 PartialCfg = 0;

	XDcfg *DcfgInstPtr = &DcfgInst;



	XDcfg_Config *ConfigPtr;

	/*
	 * Initialize the Device Configuration Interface driver.
	 */
	ConfigPtr = XDcfg_LookupConfig(XPAR_XDCFG_0_DEVICE_ID);

	/*
	 * This is where the virtual address would be used, this example
	 * uses physical address.
	 */
	Status = XDcfg_CfgInitialize(DcfgInstPtr, ConfigPtr,
					ConfigPtr->BaseAddr);
	if (Status != XST_SUCCESS) {
		return XST_FAILURE;
	}


	Status = XDcfg_SelfTest(DcfgInstPtr);
	if (Status != XST_SUCCESS) {
		return XST_FAILURE;
	}

	/*
	 * Check first time configuration or partial reconfiguration
	 */
	IntrStsReg = XDcfg_IntrGetStatus(DcfgInstPtr);
	if (IntrStsReg & XDCFG_IXR_DMA_DONE_MASK) {
		PartialCfg = 1;
	}

	/*
	 * Enable the pcap clock.
	 */
	StatusReg = Xil_In32(SLCR_PCAP_CLK_CTRL);
	if (!(StatusReg & SLCR_PCAP_CLK_CTRL_EN_MASK)) {
		Xil_Out32(SLCR_UNLOCK, SLCR_UNLOCK_VAL);
		Xil_Out32(SLCR_PCAP_CLK_CTRL,
				(StatusReg | SLCR_PCAP_CLK_CTRL_EN_MASK));
		Xil_Out32(SLCR_UNLOCK, SLCR_LOCK_VAL);
	}

	/*
	 * Disable the level-shifters from PS to PL.
	 */
	if (!PartialCfg) {
		Xil_Out32(SLCR_UNLOCK, SLCR_UNLOCK_VAL);
		Xil_Out32(SLCR_LVL_SHFTR_EN, 0xA);
		Xil_Out32(SLCR_LOCK, SLCR_LOCK_VAL);
	}

	/*
	 * Select PCAP interface for partial reconfiguration
	 */
	if (PartialCfg) {
		XDcfg_EnablePCAP(DcfgInstPtr);
		XDcfg_SetControlRegister(DcfgInstPtr, XDCFG_CTRL_PCAP_PR_MASK);
	}

	/*
	 * Clear the interrupt status bits
	 */
	XDcfg_IntrClear(DcfgInstPtr, (XDCFG_IXR_PCFG_DONE_MASK |
					XDCFG_IXR_D_P_DONE_MASK |
					XDCFG_IXR_DMA_DONE_MASK));

	/* Check if DMA command queue is full */
	StatusReg = XDcfg_ReadReg(DcfgInstPtr->Config.BaseAddr,
				XDCFG_STATUS_OFFSET);
	if ((StatusReg & XDCFG_STATUS_DMA_CMD_Q_F_MASK) ==
			XDCFG_STATUS_DMA_CMD_Q_F_MASK) {
		return XST_FAILURE;
	}

	/*
	 * Download bitstream in non secure mode
	 */

	// Set 2 LSbs to 0b01 - see example notes
	if ((uint32_t)bitfile & 0b11) {
		xil_printf("MISALIGNED ADDRESS\n");
	}
	if (bitfile_size % 4 != 0) {
		xil_printf("Size not multiple of 4! - %d extra\n", bitfile_size % 4);
	}
	bitfile = (uint8_t*)((uint32_t)bitfile | 1);


	xil_printf("Starting transfer...\n");

	XDcfg_Transfer(DcfgInstPtr, bitfile, bitfile_size/4,
			(u8 *)XDCFG_DMA_INVALID_ADDRESS,
			0, XDCFG_NON_SECURE_PCAP_WRITE);

	/* Poll IXR_DMA_DONE */
	IntrStsReg = XDcfg_IntrGetStatus(DcfgInstPtr);
	while ((IntrStsReg & XDCFG_IXR_DMA_DONE_MASK) !=
			XDCFG_IXR_DMA_DONE_MASK) {
		IntrStsReg = XDcfg_IntrGetStatus(DcfgInstPtr);
	}

	if (PartialCfg) {
		/* Poll IXR_D_P_DONE */
		while ((IntrStsReg & XDCFG_IXR_D_P_DONE_MASK) !=
				XDCFG_IXR_D_P_DONE_MASK) {
			IntrStsReg = XDcfg_IntrGetStatus(DcfgInstPtr);
		}
	} else {
		/* Poll IXR_PCFG_DONE */
		while ((IntrStsReg & XDCFG_IXR_PCFG_DONE_MASK) !=
				XDCFG_IXR_PCFG_DONE_MASK) {
			IntrStsReg = XDcfg_IntrGetStatus(DcfgInstPtr);
		}
		/*
		 * Enable the level-shifters from PS to PL.
		 */
		Xil_Out32(SLCR_UNLOCK, SLCR_UNLOCK_VAL);
		Xil_Out32(SLCR_LVL_SHFTR_EN, 0xF);
		Xil_Out32(SLCR_LOCK, SLCR_LOCK_VAL);
	}

	return XST_SUCCESS;
}







void load_bitfile1() {

	xil_printf("Loading bitfile1...\n");
	int status = XDcfgPolledExample(bitfile1, sizeof(bitfile1));
	if (status == XST_SUCCESS) {
		xil_printf("Done\n");
	} else {
		xil_printf("ERROR\n");
	}

}


#endif
