jc2brown/radio24bb/rtl/xdc/iostandard_jx2.xdc

set_property IOSTANDARD LVCMOS33 [get_ports "CODEC_MCLK"];
set_property IOSTANDARD LVCMOS33 [get_ports "CODEC_IO_CLK"];


set_property IOSTANDARD LVCMOS33 [get_ports "CODEC_BCLK"];
set_property IOSTANDARD LVCMOS33 [get_ports "CODEC_IO_DATA"];
set_property IOSTANDARD LVCMOS33 [get_ports "CODEC_WCLK"];
set_property IOSTANDARD LVCMOS33 [get_ports "CODEC_IO_INT_N"];


set_property IOSTANDARD LVCMOS33 [get_ports "CODEC_DIN"];
set_property IOSTANDARD LVCMOS33 [get_ports "ADC_CLK_P"];
set_property IOSTANDARD LVCMOS33 [get_ports "CODEC_DOUT"];
set_property IOSTANDARD LVCMOS33 [get_ports "ADC_CLK_N"];


set_property IOSTANDARD LVCMOS33 [get_ports "DAC_CLKX_P"];
set_property IOSTANDARD LVCMOS33 [get_ports "ADC_DORB"];
set_property IOSTANDARD LVCMOS33 [get_ports "DAC_CLKX_N"];
set_property IOSTANDARD LVCMOS33 [get_ports "ADC_DB[0]"];


set_property IOSTANDARD LVCMOS33 [get_ports "DAC_CWN"];
set_property IOSTANDARD LVCMOS33 [get_ports "ADC_DB[1]"];
set_property IOSTANDARD LVCMOS33 [get_ports "DAC_DB[0]"];
set_property IOSTANDARD LVCMOS33 [get_ports "ADC_DB[2]"];


set_property IOSTANDARD LVCMOS33 [get_ports "DAC_DB[1]"];
set_property IOSTANDARD LVCMOS33 [get_ports "ADC_DB[3]"];
set_property IOSTANDARD LVCMOS33 [get_ports "DAC_DB[2]"];
set_property IOSTANDARD LVCMOS33 [get_ports "ADC_DB[4]"];


set_property IOSTANDARD LVCMOS33 [get_ports "DAC_DB[3]"];
set_property IOSTANDARD LVCMOS33 [get_ports "ADC_DB[5]"];
set_property IOSTANDARD LVCMOS33 [get_ports "DAC_DB[4]"];
set_property IOSTANDARD LVCMOS33 [get_ports "ADC_DB[6]"];


set_property IOSTANDARD LVCMOS33 [get_ports "DAC_CLK"];
set_property IOSTANDARD LVCMOS33 [get_ports "ADC_DCLKB"];
set_property IOSTANDARD LVCMOS33 [get_ports "DAC_DB[5]"];
set_property IOSTANDARD LVCMOS33 [get_ports "ADC_DCLKA"];




set_property IOSTANDARD LVCMOS33 [get_ports "DAC_DB[6]"];
set_property IOSTANDARD LVCMOS33 [get_ports "ADC_DB[7]"];
set_property IOSTANDARD LVCMOS33 [get_ports "DAC_DB[7]"];
set_property IOSTANDARD LVCMOS33 [get_ports "ADC_DA[0]"];


set_property IOSTANDARD LVCMOS33 [get_ports "DAC_DA[0]"];
set_property IOSTANDARD LVCMOS33 [get_ports "ADC_DA[1]"];
set_property IOSTANDARD LVCMOS33 [get_ports "DAC_DA[1]"];
set_property IOSTANDARD LVCMOS33 [get_ports "ADC_DA[2]"];


set_property IOSTANDARD LVCMOS33 [get_ports "DAC_DA[2]"];
set_property IOSTANDARD LVCMOS33 [get_ports "ADC_DA[3]"];
set_property IOSTANDARD LVCMOS33 [get_ports "DAC_DA[3]"];
set_property IOSTANDARD LVCMOS33 [get_ports "ADC_DA[4]"];




set_property IOSTANDARD LVCMOS33 [get_ports "DAC_DA[4]"];
set_property IOSTANDARD LVCMOS33 [get_ports "ADC_DA[5]"];
set_property IOSTANDARD LVCMOS33 [get_ports "DAC_DA[5]"];
set_property IOSTANDARD LVCMOS33 [get_ports "ADC_DA[6]"];


set_property IOSTANDARD LVCMOS33 [get_ports "DAC_DA[6]"];
set_property IOSTANDARD LVCMOS33 [get_ports "ADC_DA[7]"];
set_property IOSTANDARD LVCMOS33 [get_ports "DAC_DA[7]"];
set_property IOSTANDARD LVCMOS33 [get_ports "ADC_DORA"];


set_property IOSTANDARD LVCMOS33 [get_ports "ADC_SDIN"];
set_property IOSTANDARD LVCMOS33 [get_ports "ADC_IO_CLK"];
set_property IOSTANDARD LVCMOS33 [get_ports "ADC_SCLK"];
set_property IOSTANDARD LVCMOS33 [get_ports "ADC_IO_DATA"];
set_property IOSTANDARD LVCMOS33 [get_ports "EXT_GPIO0"];

set_property IOSTANDARD LVCMOS33 [get_ports "EXT_GPIO1"];
set_property IOSTANDARD LVCMOS33 [get_ports "ADC_CSN"];
