jc2brown/radio24bb/rtl/xdc/package_pins_jx2.xdc

set_property PACKAGE_PIN G14 [get_ports "CODEC_MCLK"];
set_property PACKAGE_PIN J15 [get_ports "CODEC_IO_CLK"];


set_property PACKAGE_PIN C20 [get_ports "CODEC_BCLK"];
set_property PACKAGE_PIN B19 [get_ports "CODEC_IO_DATA"];
set_property PACKAGE_PIN B20 [get_ports "CODEC_WCLK"];
set_property PACKAGE_PIN A20 [get_ports "CODEC_IO_INT_N"];


set_property PACKAGE_PIN E17 [get_ports "CODEC_DIN"];
set_property PACKAGE_PIN D19 [get_ports "ADC_CLK_P"];
set_property PACKAGE_PIN D18 [get_ports "CODEC_DOUT"];
set_property PACKAGE_PIN D20 [get_ports "ADC_CLK_N"];


set_property PACKAGE_PIN E18 [get_ports "DAC_CLKX_P"];
set_property PACKAGE_PIN F16 [get_ports "ADC_DORB"];
set_property PACKAGE_PIN E19 [get_ports "DAC_CLKX_N"];
set_property PACKAGE_PIN F17 [get_ports "ADC_DB[0]"];


set_property PACKAGE_PIN L19 [get_ports "DAC_CWN"];
set_property PACKAGE_PIN M19 [get_ports "ADC_DB[1]"];
set_property PACKAGE_PIN L20 [get_ports "DAC_DB[0]"];
set_property PACKAGE_PIN M20 [get_ports "ADC_DB[2]"];


set_property PACKAGE_PIN M17 [get_ports "DAC_DB[1]"];
set_property PACKAGE_PIN K19 [get_ports "ADC_DB[3]"];
set_property PACKAGE_PIN M18 [get_ports "DAC_DB[2]"];
set_property PACKAGE_PIN J19 [get_ports "ADC_DB[4]"];


set_property PACKAGE_PIN H18 [get_ports "DAC_DB[3]"];
set_property PACKAGE_PIN K17 [get_ports "ADC_DB[5]"];
set_property PACKAGE_PIN L17 [get_ports "DAC_DB[4]"];
set_property PACKAGE_PIN K18 [get_ports "ADC_DB[6]"];


set_property PACKAGE_PIN H16 [get_ports "DAC_CLK"];
set_property PACKAGE_PIN J18 [get_ports "ADC_DCLKB"];
set_property PACKAGE_PIN H17 [get_ports "DAC_DB[5]"];
set_property PACKAGE_PIN L16 [get_ports "ADC_DCLKA"];




set_property PACKAGE_PIN G17 [get_ports "DAC_DB[6]"];
set_property PACKAGE_PIN F19 [get_ports "ADC_DB[7]"];
set_property PACKAGE_PIN G18 [get_ports "DAC_DB[7]"];
set_property PACKAGE_PIN F20 [get_ports "ADC_DA[0]"];


set_property PACKAGE_PIN G19 [get_ports "DAC_DA[0]"];
set_property PACKAGE_PIN J20 [get_ports "ADC_DA[1]"];
set_property PACKAGE_PIN G20 [get_ports "DAC_DA[1]"];
set_property PACKAGE_PIN H20 [get_ports "ADC_DA[2]"];


set_property PACKAGE_PIN K14 [get_ports "DAC_DA[2]"];
set_property PACKAGE_PIN H15 [get_ports "ADC_DA[3]"];
set_property PACKAGE_PIN J14 [get_ports "DAC_DA[3]"];
set_property PACKAGE_PIN G15 [get_ports "ADC_DA[4]"];




set_property PACKAGE_PIN N15 [get_ports "DAC_DA[4]"];
set_property PACKAGE_PIN L14 [get_ports "ADC_DA[5]"];
set_property PACKAGE_PIN N16 [get_ports "DAC_DA[5]"];
set_property PACKAGE_PIN L15 [get_ports "ADC_DA[6]"];


set_property PACKAGE_PIN M14 [get_ports "DAC_DA[6]"];
set_property PACKAGE_PIN K16 [get_ports "ADC_DA[7]"];
set_property PACKAGE_PIN M15 [get_ports "DAC_DA[7]"];
set_property PACKAGE_PIN J16 [get_ports "ADC_DORA"];


set_property PACKAGE_PIN Y12 [get_ports "ADC_SDIN"];
set_property PACKAGE_PIN V11 [get_ports "ADC_IO_CLK"];
set_property PACKAGE_PIN Y13 [get_ports "ADC_SCLK"];
set_property PACKAGE_PIN V10 [get_ports "ADC_IO_DATA"];
set_property PACKAGE_PIN V6 [get_ports "EXT_GPIO0"];

set_property PACKAGE_PIN W6 [get_ports "EXT_GPIO1"];
set_property PACKAGE_PIN V5 [get_ports "ADC_CSN"];
