jc2brown/radio24bb/rtl/xdc/package_pins_jx1.xdc

set_property PACKAGE_PIN R19 [get_ports "USB_IO_CLK"];

set_property PACKAGE_PIN T11 [get_ports "USB_IO_DATA"];
set_property PACKAGE_PIN T12 [get_ports "USB_D[0]"];
set_property PACKAGE_PIN T10 [get_ports "USB_IO_INT_N"];
set_property PACKAGE_PIN U12 [get_ports "USB_D[1]"];


set_property PACKAGE_PIN U13 [get_ports "USB_D[2]"];
set_property PACKAGE_PIN V12 [get_ports "USB_D[4]"];
set_property PACKAGE_PIN V13 [get_ports "USB_D[3]"];
set_property PACKAGE_PIN W13 [get_ports "USB_D[5]"];


set_property PACKAGE_PIN T14 [get_ports "USB_D[6]"];
set_property PACKAGE_PIN P14 [get_ports "USB_D[8]"];
set_property PACKAGE_PIN T15 [get_ports "USB_D[7]"];
set_property PACKAGE_PIN R14 [get_ports "USB_D[9]"];


set_property PACKAGE_PIN Y16 [get_ports "USB_D[10]"];
set_property PACKAGE_PIN W14 [get_ports "USB_D[12]"];
set_property PACKAGE_PIN Y17 [get_ports "USB_D[11]"];
set_property PACKAGE_PIN Y14 [get_ports "USB_D[13]"];


set_property PACKAGE_PIN T16 [get_ports "USB_D[14]"];
set_property PACKAGE_PIN V15 [get_ports "USB_D[16]"];
set_property PACKAGE_PIN U17 [get_ports "USB_D[15]"];
set_property PACKAGE_PIN W15 [get_ports "USB_D[17]"];


set_property PACKAGE_PIN U14 [get_ports "USB_D[18]"];
set_property PACKAGE_PIN U18 [get_ports "USB_D[20]"];
set_property PACKAGE_PIN U15 [get_ports "USB_D[19]"];
set_property PACKAGE_PIN U19 [get_ports "USB_D[21]"];


set_property PACKAGE_PIN N18 [get_ports "USB_CLK"];
set_property PACKAGE_PIN N20 [get_ports "USB_D[23]"];
set_property PACKAGE_PIN P19 [get_ports "USB_D[22]"];
set_property PACKAGE_PIN P20 [get_ports "USB_D[24]"];


set_property PACKAGE_PIN T20 [get_ports "USB_D[25]"];
set_property PACKAGE_PIN V20 [get_ports "USB_D[27]"];
set_property PACKAGE_PIN U20 [get_ports "USB_D[26]"];
set_property PACKAGE_PIN W20 [get_ports "USB_D[28]"];




set_property PACKAGE_PIN Y18 [get_ports "USB_D[29]"];
set_property PACKAGE_PIN V16 [get_ports "USB_D[31]"];
set_property PACKAGE_PIN Y19 [get_ports "USB_D[30]"];
set_property PACKAGE_PIN W16 [get_ports "USB_BE[0]"];


set_property PACKAGE_PIN R16 [get_ports "USB_BE[1]"];
set_property PACKAGE_PIN T17 [get_ports "USB_BE[3]"];
set_property PACKAGE_PIN R17 [get_ports "USB_BE[2]"];
set_property PACKAGE_PIN R18 [get_ports "USB_TXE_N"];


set_property PACKAGE_PIN V17 [get_ports "USB_RXF_N"];
set_property PACKAGE_PIN W18 [get_ports "USB_WR_N"];
set_property PACKAGE_PIN V18 [get_ports "USB_SIWU_N"];
set_property PACKAGE_PIN W19 [get_ports "USB_RD_N"];





set_property PACKAGE_PIN P15 [get_ports "USB_OE_N"];


set_property PACKAGE_PIN V8 [get_ports "LED0"];
set_property PACKAGE_PIN W8 [get_ports "LED1"];



set_property PACKAGE_PIN U7 [get_ports "DAC_IO_DATA"];
set_property PACKAGE_PIN T9 [get_ports "TCXO_19M2"];
set_property PACKAGE_PIN V7 [get_ports "DAC_IO_CLK"];


set_property PACKAGE_PIN K9 [get_ports "VP"];
set_property PACKAGE_PIN L10 [get_ports "VN"];
