jc2brown/radio24bb/rtl/xdc/iostandard_jx1.xdc

set_property IOSTANDARD LVCMOS25 [get_ports "USB_IO_CLK"];

set_property IOSTANDARD LVCMOS25 [get_ports "USB_IO_DATA"];
set_property IOSTANDARD LVCMOS25 [get_ports "USB_D[0]"];
set_property IOSTANDARD LVCMOS25 [get_ports "USB_IO_INT_N"];
set_property IOSTANDARD LVCMOS25 [get_ports "USB_D[1]"];


set_property IOSTANDARD LVCMOS25 [get_ports "USB_D[2]"];
set_property IOSTANDARD LVCMOS25 [get_ports "USB_D[4]"];
set_property IOSTANDARD LVCMOS25 [get_ports "USB_D[3]"];
set_property IOSTANDARD LVCMOS25 [get_ports "USB_D[5]"];


set_property IOSTANDARD LVCMOS25 [get_ports "USB_D[6]"];
set_property IOSTANDARD LVCMOS25 [get_ports "USB_D[8]"];
set_property IOSTANDARD LVCMOS25 [get_ports "USB_D[7]"];
set_property IOSTANDARD LVCMOS25 [get_ports "USB_D[9]"];


set_property IOSTANDARD LVCMOS25 [get_ports "USB_D[10]"];
set_property IOSTANDARD LVCMOS25 [get_ports "USB_D[12]"];
set_property IOSTANDARD LVCMOS25 [get_ports "USB_D[11]"];
set_property IOSTANDARD LVCMOS25 [get_ports "USB_D[13]"];


set_property IOSTANDARD LVCMOS25 [get_ports "USB_D[14]"];
set_property IOSTANDARD LVCMOS25 [get_ports "USB_D[16]"];
set_property IOSTANDARD LVCMOS25 [get_ports "USB_D[15]"];
set_property IOSTANDARD LVCMOS25 [get_ports "USB_D[17]"];


set_property IOSTANDARD LVCMOS25 [get_ports "USB_D[18]"];
set_property IOSTANDARD LVCMOS25 [get_ports "USB_D[20]"];
set_property IOSTANDARD LVCMOS25 [get_ports "USB_D[19]"];
set_property IOSTANDARD LVCMOS25 [get_ports "USB_D[21]"];


set_property IOSTANDARD LVCMOS25 [get_ports "USB_CLK"];
set_property IOSTANDARD LVCMOS25 [get_ports "USB_D[23]"];
set_property IOSTANDARD LVCMOS25 [get_ports "USB_D[22]"];
set_property IOSTANDARD LVCMOS25 [get_ports "USB_D[24]"];


set_property IOSTANDARD LVCMOS25 [get_ports "USB_D[25]"];
set_property IOSTANDARD LVCMOS25 [get_ports "USB_D[27]"];
set_property IOSTANDARD LVCMOS25 [get_ports "USB_D[26]"];
set_property IOSTANDARD LVCMOS25 [get_ports "USB_D[28]"];




set_property IOSTANDARD LVCMOS25 [get_ports "USB_D[29]"];
set_property IOSTANDARD LVCMOS25 [get_ports "USB_D[31]"];
set_property IOSTANDARD LVCMOS25 [get_ports "USB_D[30]"];
set_property IOSTANDARD LVCMOS25 [get_ports "USB_BE[0]"];


set_property IOSTANDARD LVCMOS25 [get_ports "USB_BE[1]"];
set_property IOSTANDARD LVCMOS25 [get_ports "USB_BE[3]"];
set_property IOSTANDARD LVCMOS25 [get_ports "USB_BE[2]"];
set_property IOSTANDARD LVCMOS25 [get_ports "USB_TXE_N"];


set_property IOSTANDARD LVCMOS25 [get_ports "USB_RXF_N"];
set_property IOSTANDARD LVCMOS25 [get_ports "USB_SIWU_N"];
set_property IOSTANDARD LVCMOS25 [get_ports "USB_RD_N"];
set_property IOSTANDARD LVCMOS25 [get_ports "USB_WR_N"];





set_property IOSTANDARD LVCMOS25 [get_ports "USB_OE_N"];


set_property IOSTANDARD LVCMOS33 [get_ports "LED0"];
set_property IOSTANDARD LVCMOS33 [get_ports "LED1"];


set_property IOSTANDARD LVCMOS33 [get_ports "DAC_IO_DATA"];
set_property IOSTANDARD LVCMOS33 [get_ports "TCXO_19M2"];
set_property IOSTANDARD LVCMOS33 [get_ports "DAC_IO_CLK"];
