jc2brown/radio24bb/rtl/tb/gen_tone.sv

`timescale 1ps / 1ps


module gen_tone
#(
     parameter real AMPL = 1.0,
     parameter real FREQ = 10e6,   
     parameter real VCM = 0,
     parameter real CM_NOISE_AMPL = 0.0,
     parameter real DM_NOISE_AMPL = 0.0,
//     parameter real SIG_CLK_PER = 1e12 / (51*FREQ), // 51 samples per signal period
//     parameter real NOISE_CLK_PER = SIG_CLK_PER / 3 // 3 noise samples per signal sample   
     parameter real SAMPLE_RATE = 100e6,
     parameter real PHASE_DELTA_INC = 0
     
)
(
    output wire [31:0] sig_p_uv,
    output wire [31:0] sig_n_uv,
    output wire clkout
);
    
    
    
localparam real SIG_CLK_PER = 1e12 / SAMPLE_RATE;
localparam real NOISE_CLK_PER = SIG_CLK_PER / 4.0;
    
    
    
reg sigclk = 1'b0;
always #(SIG_CLK_PER/2) sigclk <= !sigclk;

assign clkout = sigclk;

reg noiseclk = 1'b0;
always #(NOISE_CLK_PER/2) noiseclk <= !noiseclk;

reg reset = 1'b1;
initial #10000 @(posedge noiseclk) reset <= 1'b0;

reg enable = 1'b0;
initial #100000 @(posedge noiseclk) enable <= 1'b1;



wire signed [16:0] cm_noise_raw;
wire signed [16:0] dm_p_noise_raw;
wire signed [16:0] dm_n_noise_raw;

prbs #(
    .SEED(23'b1111_1111_1111_0000_0000_001)
) cm_noisegen (
    .clk(noiseclk),                 
    .reset(reset),             
    .en(enable),                  
    .init(0),                
    .data(cm_noise_raw)
);

prbs #(
    .SEED(23'b1111_1111_1111_0000_0000_010)
) dm_n_noisegen (
    .clk(noiseclk),               
    .reset(reset),             
    .en(enable),                  
    .init(0),                
    .data(dm_n_noise_raw)
);
    
prbs #(
   .SEED(23'b1111_1111_1111_0000_0000_100)
) dm_p_noisegen (
    .clk(noiseclk),               
    .reset(reset),             
    .en(enable),                  
    .init(0),                
    .data(dm_p_noise_raw)
);



reg signed [31:0] cm_noise_uv;
reg signed [31:0] dm_p_noise_uv;
reg signed [31:0] dm_n_noise_uv;

     
     
wire signed [31:0] cm_noise_ampl_uv   = CM_NOISE_AMPL * 1e6;
wire signed [31:0] dm_p_noise_ampl_uv =  DM_NOISE_AMPL * 1e6;
wire signed [31:0] dm_n_noise_ampl_uv =  DM_NOISE_AMPL * 1e6;

always @* begin
    cm_noise_uv = ((cm_noise_ampl_uv * signed'(cm_noise_raw)) / 2**16);// - cm_noise_ampl_uv);
    dm_p_noise_uv = ((dm_p_noise_ampl_uv * signed'(dm_p_noise_raw)) / 2**16);// - dm_p_noise_ampl_uv);
    dm_n_noise_uv = ((dm_n_noise_ampl_uv * signed'(dm_n_noise_raw)) / 2**16);// - dm_n_noise_ampl_uv);
end


localparam real SAMPLES_PER_PERIOD = SAMPLE_RATE / FREQ;


real phase = 0;
real phasedelta = 2*3.1415/SAMPLES_PER_PERIOD;
always @(posedge sigclk) phasedelta <= phasedelta + PHASE_DELTA_INC;

always @(posedge sigclk) phase <= phase + phasedelta;

wire signed [31:0] sig_ampl_uv = AMPL * 1e6;   //400000; //375000;
wire signed [31:0] sig_uv = signed'(sig_ampl_uv) * $sin(phase);


wire signed [31:0] cm_uv = VCM * 1e6;

assign sig_p_uv = (cm_uv + sig_uv) + cm_noise_uv + dm_p_noise_uv;
assign sig_n_uv = (cm_uv - sig_uv) + cm_noise_uv + dm_n_noise_uv;





    
    
endmodule
