jc2brown/radio24bb/rtl/hdl/pcal6416a_if.sv

// Controller for the PCAL6416A I2C I/O expander
// Talks to i2c_basic
// Automatically updates up to 16 output pins on a PCAL6416A

// Interrupt is cleared when data is read from the port that originated it 

module pcal6416a_ctrl
#(
)
(
    input clk,
    input reset,
    
    input enable,
            
    input [15:0] in,    
    output reg [15:0] out,
    output reg out_valid,
    
    input write,
    input read,
//    input [15:0] in_d1,
//    input irq,
    
    input [15:0] inputs,
    input start_init,    
    
    input start,
    output reg done,
    
    output i2c_start,
    input i2c_done,
    
    input [6:0] addr,
    
    output reg [1:0] num_wr_bytes,
    output reg [7:0] wr_data0,
    output reg [7:0] wr_data1,
    output reg [7:0] wr_data2,
        
    output reg [1:0] num_rd_bytes,
    input [7:0] rd_data0,
    input [7:0] rd_data1
    
);
    
reg [3:0] state;


localparam STATE_INIT1 = 0;
localparam STATE_INIT2 = 1;
localparam STATE_INIT3 = 2;
localparam STATE_INIT4 = 3;
localparam STATE_IDLE = 4;
localparam STATE_UPDATE = 5;
localparam STATE_WRITE0 = 6;
localparam STATE_WRITE1 = 7;
localparam STATE_READ0 = 8;
localparam STATE_READ1 = 9;
localparam STATE_READ2 = 10;
localparam STATE_READ3 = 11;




reg do_read;
reg do_write;

assign i2c_start = 
    (state == STATE_INIT1) || 
    (state == STATE_INIT3) || 
    (state == STATE_WRITE0) ||
    (state == STATE_READ0) ||
    (state == STATE_READ2);


always @(posedge clk) begin
    if (reset) begin
        state <= STATE_IDLE;
        //i2c_start <= 0;
        wr_data0 <= 0;
        wr_data1 <= 0;
        wr_data2 <= 0;
        do_read <= 0;
        do_write <= 0;
        done <= 0;
        out <= 0;
        out_valid <= 0;
    end
    else begin
    
        out_valid <= 0;      
    
        if (enable) begin
        
        
            case (state)
            
            
            STATE_IDLE: begin
                done <= 1;                
                
                if (start_init) begin
                    done <= 0;
                    num_wr_bytes <= 3;
                    num_rd_bytes <= 0;
                    wr_data0 <= 8'h06; // Config port
                    wr_data1 <= inputs[7:0];
                    wr_data2 <= inputs[15:8];  
                    state <= STATE_INIT1;
                end                                
                                
                if (start) begin                
                    do_write <= write;//(in != in_d1);
                    do_read <= read;//irq;
                    done <= 0;
                    state <= STATE_UPDATE;
                end
            end
            
            
            STATE_INIT1: begin      
                state <= STATE_INIT2;
            end           
            STATE_INIT2: begin
                if (i2c_done) begin
                    num_wr_bytes <= 3;
                    num_rd_bytes <= 0;
                    wr_data0 <= 8'h4A; // Interrupt mask
                    wr_data1 <= ~inputs[7:0];
                    wr_data2 <= ~inputs[15:8];  
                    state <= STATE_INIT3;
                end
            end
                           
            
            STATE_INIT3: begin  
                state <= STATE_INIT4;
            end           
            STATE_INIT4: begin
                if (i2c_done) begin
                    do_read <= 1;
                    do_write <= 1;
                    state <= STATE_UPDATE;
                end
            end
            
            
            STATE_UPDATE: begin
                
                if (do_read) begin       
                    num_wr_bytes <= 1;
                    num_rd_bytes <= 0;
                    wr_data0 <= 8'h00; // Input port        
                    state <= STATE_READ0;
                end
                else if (do_write) begin
                    num_wr_bytes <= 3;
                    num_rd_bytes <= 0;
                    wr_data0 <= 8'h02; // Output port
                    wr_data1 <= in[7:0];
                    wr_data2 <= in[15:8];         
                    state <= STATE_WRITE0;
                end
                else begin
                    state <= STATE_IDLE;
                end                            
            end
                                              
                        
            STATE_WRITE0: begin  
                state <= STATE_WRITE1;
            end
            STATE_WRITE1: begin  
                if (i2c_done) begin
                    do_write <= 0;
                    state <= STATE_UPDATE;
                end
            end
                     
                        
            STATE_READ0: begin   
                state <= STATE_READ1;
            end
            STATE_READ1: begin  
                if (i2c_done) begin
                    num_wr_bytes <= 0;
                    num_rd_bytes <= 2;
                    state <= STATE_READ2;
                end
            end                                        
            STATE_READ2: begin       
                state <= STATE_READ3;
            end
            STATE_READ3: begin  
                if (i2c_done) begin
                    do_read <= 0;
                    out <= {rd_data1, rd_data0};         
                    out_valid <= 1;      
                    state <= STATE_UPDATE;
                end
            end
                        
            endcase
            
        end
            
    end
end
    
    
   
    
    
    
    
    
    
    
    
    
    
    
    
    
    
    
    
    
    
    
    
endmodule
