jc2brown/radio24bb/fw/src/aic3204.h

#include "xspips.h"
#include "command.h"



#ifndef AIC3204_H
#define AIC3204_H



struct aic3204 {
	XSpiPs *spips;
	uint8_t page;
};




struct aic3204 *make_aic3204();
int init_aic3204(struct aic3204 *aic, XSpiPs *spips, struct cmd_context *parent_ctx);




#endif
