jc2brown/radio24bb/fw/src/scugic.h

#ifndef SCUGIC_H
#define SCUGIC_H

#include "xscugic.h"



#define INTC_DEVICE_INT_ID	XPAR_FABRIC_IRQ_F2P_01_INTR



#define CS_START()   int ireg = mfcpsr(); Xil_ExceptionDisable()
#define CS_END()     mtcpsr(ireg)




XScuGic *make_scugic();
int init_scugic(XScuGic *scugic, int device_id);



#endif
