jc2brown/radio24bb/fw/src/getchar_nonblock.c

#if 0

#include "xparameters_ps.h"

#include "xuartps.h"


int DeviceId = XPAR_PS7_UART_1_DEVICE_ID;

int inited = 0;


int Init_UartPs() {
	if (inited) {
		return;
	}
	int Status;
	XUartPs_Config *Config;
	unsigned int SentCount;
	unsigned int ReceivedCount;
	u16 Index;
	u32 LoopCount = 0;

	/*
	 * Initialize the UART driver so that it's ready to use.
	 * Look up the configuration in the config table, then initialize it.
	 */
	Config = XUartPs_LookupConfig(DeviceId);
	if (NULL == Config) {
		return XST_FAILURE;
	}

	Status = XUartPs_CfgInitialize(&Uart_PS, Config, Config->BaseAddress);
	if (Status != XST_SUCCESS) {
		return XST_FAILURE;
	}

	/* Check hardware build. */
	Status = XUartPs_SelfTest(&Uart_PS);
	if (Status != XST_SUCCESS) {
		return XST_FAILURE;
	}

	inited = 1;
	return 0;

}



int UartPsPolledExample()
{


	int Status;
	XUartPs_Config *Config;
	unsigned int SentCount;
	unsigned int ReceivedCount;
	u16 Index;
	u32 LoopCount = 0;


	Init_UartPs();



	/*
	 * Initialize the send buffer bytes with a pattern and zero out
	 * the receive buffer.
	 */
	for (Index = 0; Index < TEST_BUFFER_SIZE; Index++) {
		SendBuffer[Index] = '0' + Index;
		RecvBuffer[Index] = 0;
	}

	/* Block sending the buffer. */
	SentCount = XUartPs_Send(&Uart_PS, SendBuffer, TEST_BUFFER_SIZE);
	if (SentCount != TEST_BUFFER_SIZE) {
		return XST_FAILURE;
	}

	/*
	 * Wait while the UART is sending the data so that we are guaranteed
	 * to get the data the 1st time we call receive, otherwise this function
	 * may enter receive before the data has arrived
	 */
	while (XUartPs_IsSending(&Uart_PS)) {
		LoopCount++;
	}

	/* Block receiving the buffer. */
	ReceivedCount = 0;
	while (ReceivedCount < TEST_BUFFER_SIZE) {
		ReceivedCount +=
			XUartPs_Recv(&Uart_PS, &RecvBuffer[ReceivedCount],
				      (TEST_BUFFER_SIZE - ReceivedCount));
	}

	/*
	 * Check the receive buffer against the send buffer and verify the
	 * data was correctly received
	 */
	for (Index = 0; Index < TEST_BUFFER_SIZE; Index++) {
		if (SendBuffer[Index] != RecvBuffer[Index]) {
			return XST_FAILURE;
		}
	}



	return XST_SUCCESS;
}





#endif
