jc2brown/radio24bb/(commit log)

2019-12-09 More DAC/ADC commands
2019-12-09 User gain block in DAC/ADC channels
2019-12-10 Multiple driver
2019-12-10 Create DDS driver
2019-12-12 SPI fixes
2019-12-21 Audio fixes and makefile dep fix
    [aic3204.c, main.c, r24bb_top.sv]
2019-12-21 AIC LDO fix, add DDS aud src
    [aic3204.c, dds.c, r24bb_top.sv]
2019-12-23 Fix multi driver
2019-12-23 Add mpx driver
2019-12-28 PS I2C -> IOEXP
2019-12-28 WIP I2C IOEXP
2019-12-31 IOEXP F2P interrupts working
2019-12-31 ioexp fixes and add FAT
    [aic3204.c, fatfs.c, ioexp.c, ioexp.h, main.c, radio24bb.c]
2020-01-01 Fix warnings, no more sources list
    [adc.c, adc.h, aic3204.c, command.c, command.h, dac.c, dac.h, fatfs.c]
2020-01-01 UART interrupts
2020-01-01 UART rx interrupts
2020-01-01 Fix uart intrs
2020-01-05 Basic async playback working, no DMA
2020-01-06 Basic DMA playback working
2020-01-09 Remove mpx filter - temporarily?
2020-01-27 mcfifo + pgtest + fix xdc
    [ft601_mcfifo.sv, ft601_mcfifo_if.sv, ft601_mcfifo_rd_buf.sv, ft601_mcfifo_wr_buf.sv, ft601_wr_buf.sv, tb_mcfifo_wr_buf.sv]
